ETML-ES-SLO/PRJ_2002_CapteurMeteoWifi/2002_C/doc/PV/ProcèsVerbal_05.09.2024.docx

TD 2002 Capteur Wi-fi

Procès-verbal - du 05.09.2024

Présents

- M. Marques (JMS)
- M. Bovey (PBY)

État des lieux

- Software :
  1. Fonctionnement du capteur pour ensuite réaliser l’algorithme pour une prévision météo : 100%
  2. Communication avec la RTC, configuration du mode réveil : 90%
  3. Communication USB-UART : 90%
  4. Configuration de l’ESP32, PC-ESP32 : 100%
  5. Communication UART de l’ESP32, uC-ESP32 : 90%
  6. Sauvegarde data dans la flash : 90%
  7. Algorithme et analyse sur les data : 70%
  8. Algorithme sur la gestion de la LED RGB : 30%
  9. Algorithme sur la gestion d’alimentation : 30%

Problèmes rencontrés

- Sauvegarde dans la flash bloquer.
- Pas de communication avec la RTC.

Solutions proposées

- Faire les test et mesure pour la RTC avec Kit de PIC32 de l’écoel

Décisions prises

- Arrêter la partie firmware et se concentrer sur le rapport

Suite du projet / objectifs

Finir le rapport

Prochaine réunion :

Destinataires de ce PV

- Aurélie Cuagnier, Secrétaire de l’ETML-ES
- Philippe Bovey, Maître de diplôme

Lausanne le 05.09.2024

Joao Marques Chaves

Ecole supérieure, école des métiers Lausanne V.1-0 Rue de Sébeillon 12 DR / 13.08.2020 du 09.09.2024 CH-1004 Lausanne www.etml-es.ch H:\2002_C\doc\PV\ProcèsVerbal_05.09.2024.docx | 1 / 1 |

ETML – Ecole supérieure
