ETML-ES-SLO/PRJ_2002_CapteurMeteoWifi/2002_C/doc/PV/ProcèsVerbal_14.08.2024.docx

TD 2002 Capteur Wi-fi

Procès-verbal - du 14.08.2024

Présents

- M. Marques (JMS)
- M. Bovey (PBY)

État des lieux

- Schématique :
  - Alimentation.
    - USB-C
      - Convertisseur USB-UART
    - Pile/Accu
      - Contrôleur de charge.
        - Commande MOSFET.
  - RTC
  - ESP32
  - Capteur (humidité, température, pression, qualité d’air).
  - Led RGB, Led de vie
- Revue de Schéma avec M.Bovey le lundi 12.08.2024.
- Planning.
  - Il y a eu une déviation par rapport à ce qui était prévu (1 à 2 jours de retard). Une partie de ce retard est due au temps passé lors de la première semaine à effectuer des tests sur le prototype actuel.

Problèmes rencontrés

- Alimentation :
  - Contrôleur de charge :
    - Commande MOSFET, il s’agit d’un MOSFET qui est commandé par l’une des sorties des microcontrôleurs. Son rôle est de débrancher les piles/accumulateurs en cas de problème détecté lors de la charge ou si des piles non rechargeables sont détectées.
      - Difficulté à estimer les caractéristiques du MOSFET, telles que VGS (th).

Solutions proposées

- Alimentation :
  - Contrôleur de charge :
    - Tension VGS (th) doit commuter à partir de 3v, tension a la source 6V et à la gâte 3.3, cela fait une différence de 2.7V. Rechercher un MOSFET à canal P avec un VGS (th) de minium 3V.

Décisions prises

- Alimentation :
  - Contrôleur de charge :
    - Recherche d’un MOSFET a canal P avec un VGS (th) de minimum 3V garanti pour un courant max 1-2A.

Suite du projet / objectifs

- Commande de composant
- Réalisation du PCB
- Connaitre les contraintes pour le boitier, pour une idée globale du design.
- Rapport
  - Finir la rédaction de la prés-étude.
  - Finir la rédaction du design.

Prochaine réunion :

16.08.2024, 16h30, salle R110 ETML-ES Revu du PCB

21.08.2024, 10h00, salle R110 ETML-ES Séance classique

Destinataires de ce PV

- Grégoire Rossier, Doyen de l’ETML-ES
- Philippe Bovey, Maître de diplôme

Lausanne le 14.08.2024

Joao Marques Chaves

Ecole supérieure, école des métiers Lausanne V.1-0 Rue de Sébeillon 12 DR / 13.08.2020 du 16.08.2024 CH-1004 Lausanne www.etml-es.ch H:\2002_C\doc\PV\ProcèsVerbal_14.08.2024.docx | 1 / 1 |

ETML – Ecole supérieure
