ETML-ES-SLO/PRJ_2002_CapteurMeteoWifi/2002_C/doc/2002_CapteurMeteoWifi-PLANNING.pdf

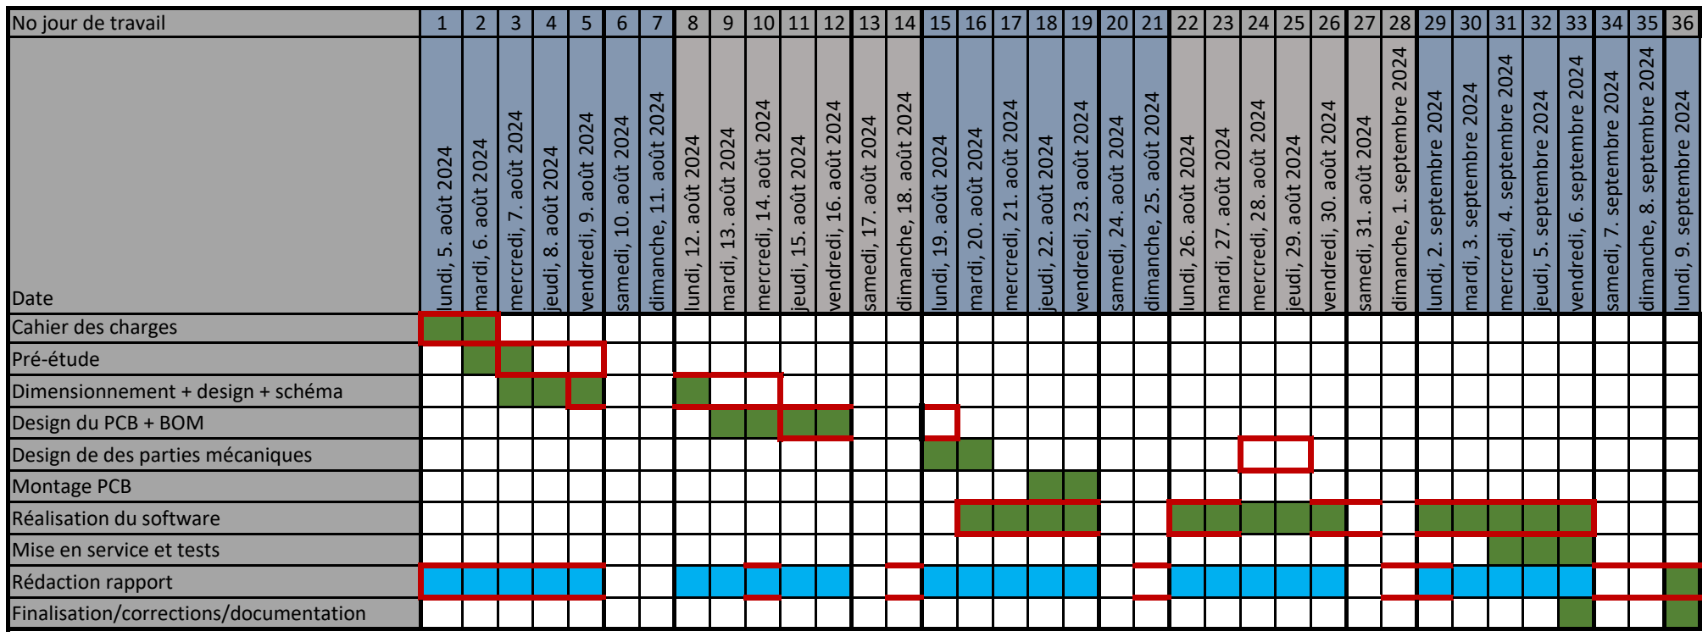
[picture p1: figure]
No jour de travail; Date; lundi, 5. août 2024; mardi, 6. août 2024; mercredi, 7. août 2024; jeudi, 8. août 2024; vendredi, 9. août 2024; samedi, 10. août 2024; dimanche, 11. août 2024; lundi, 12. août 2024; mardi, 13. août 2024; mercredi, 14. août 2024; jeudi, 15. août 2024; vendredi, 16. août 2024; samedi, 17. août 2024; dimanche, 18. août 2024; lundi, 19. août 2024; mardi, 20. août 2024; mercredi, 21. août 2024; jeudi, 22. août 2024; vendredi, 23. août 2024; samedi, 24. août 2024; dimanche, 25. août 2024; lundi, 26. août 2024; mardi, 27. août 2024; mercredi, 28. août 2024; jeudi, 29. août 2024; vendredi, 30. août 2024; samedi, 31. août 2024; dimanche, 1. septembre 2024; lundi, 2. septembre 2024; mardi, 3. septembre 2024; mercredi, 4. septembre 2024; jeudi, 5. septembre 2024; vendredi, 6. septembre 2024; samedi, 7. septembre 2024; dimanche, 8. septembre 2024; lundi, 9. septembre 2024; Cahier des charges Pré-étude Dimensionnement + design + schéma Design du PCB + BOM Design de des parties mécaniques Montage PCB Réalisation du software Mise en service et tests Rédaction rapport Finalisation/corrections/documentation
