ETML-ES-SLO/PRJ_2002_CapteurMeteoWifi/2002_C/hard/2002_C/Project Outputs for 2002_CapteurMeteoWifi/DesignDocs/Bill of Materials.PDF

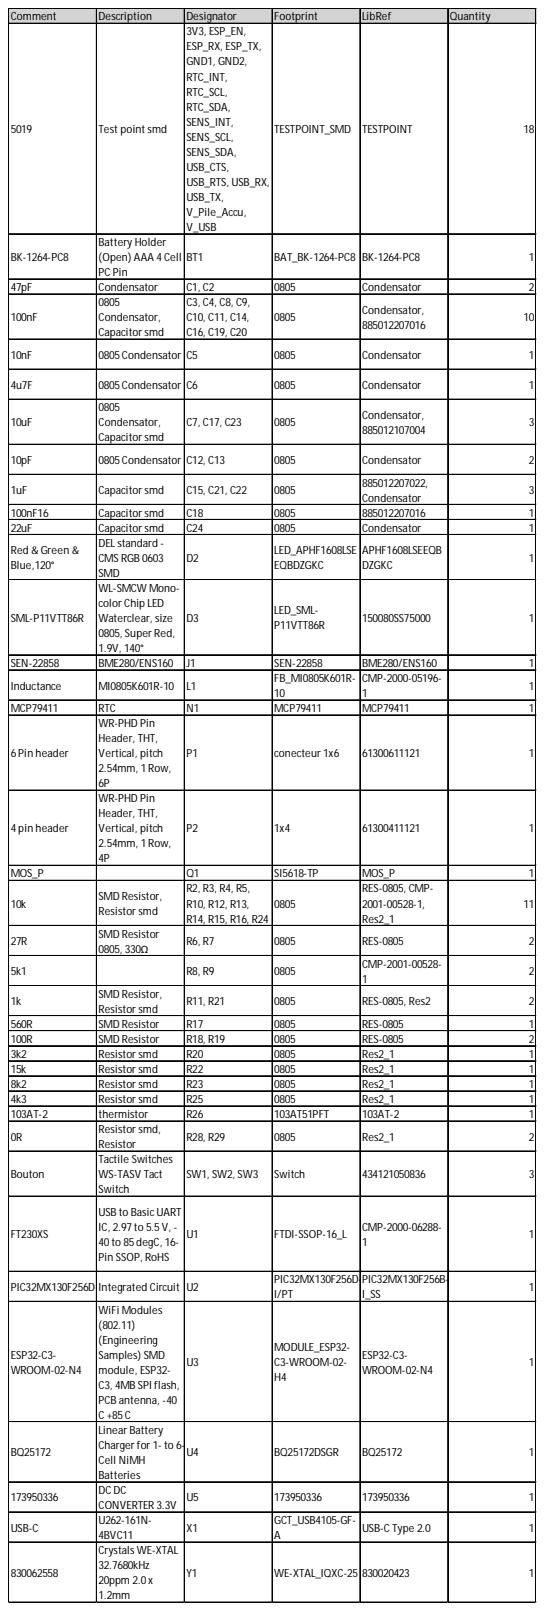
[picture p69: page 1]

Comment | Description | Designator | Footprint | LibRef | Quantity
5019 | Test point smd | 3V3, ESP_EN, ESP_RX, ESP_TX, GND1, GND2, RTC_INT, RTC_SCL, RTC_SDA, SENS_INT, SENS_SCL, SENS_SDA, USB_CTS, USB_RTS, USB_RX, USB_TX, V_Pile_Accu, V_USB | TESTPOINT_SMD | TESTPOINT | 18

BK-1264-PC8 | Battery Holder (Open) AAA 4 Cell PC Pin | BT1 | BAT_BK-1264-PC8 | BK-1264-PC8 | 1

47pF | Condensator | C1, C2 | 0805 | Condensator | 2
100nF | 0805 Condensator, Capacitor smd | C3, C4, C8, C9, C10, C11, C14, C16, C19, C20 | 0805 | Condensator, 885012207016 | 10

10nF | 0805 Condensator | C5 | 0805 | Condensator | 1

4u7F | 0805 Condensator | C6 | 0805 | Condensator | 1

10uF | 0805 Condensator, Capacitor smd | C7, C17, C23 | 0805 | Condensator, 885012107004 | 3

10pF | 0805 Condensator | C12, C13 | 0805 | Condensator | 2

1uF | Capacitor smd | C15, C21, C22 | 0805 | 885012207022, Condensator | 3

100nF16 | Capacitor smd | C18 | 0805 | 885012207016 | 1
22uF | Capacitor smd | C24 | 0805 | Condensator | 1
Red & Green & Blue,120° | DEL standard -CMS RGB 0603 SMD | D2 | LED_APHF1608LSE EQBDZGKC | APHF1608LSEEQB DZGKC | 1

SML-P11VTT86R | WL-SMCW Mono-color Chip LED Waterclear, size 0805, Super Red, 1.9V, 140° | D3 | LED_SML-P11VTT86R | 150080SS75000 | 1

SEN-22858 | BME280/ENS160 | J1 | SEN-22858 | BME280/ENS160 | 1
Inductance | MI0805K601R-10 | L1 | FB_MI0805K601R-10 | CMP-2000-05196-1 | 1

MCP79411 | RTC | N1 | MCP79411 | MCP79411 | 1
6 Pin header | WR-PHD Pin Header, THT, Vertical, pitch 2.54mm, 1 Row, 6P | P1 | conecteur 1x6 | 61300611121 | 1

4 pin header | WR-PHD Pin Header, THT, Vertical, pitch 2.54mm, 1 Row, 4P | P2 | 1x4 | 61300411121 | 1

MOS_P | | Q1 | SI5618-TP | MOS_P | 1
10k | SMD Resistor, Resistor smd | R2, R3, R4, R5, R10, R12, R13, R14, R15, R16, R24 | 0805 | RES-0805, CMP-2001-00528-1, Res2_1 | 11

27R | SMD Resistor 0805, 330Ω | R6, R7 | 0805 | RES-0805 | 2

5k1 | | R8, R9 | 0805 | CMP-2001-00528-1 | 2

1k | SMD Resistor, Resistor smd | R11, R21 | 0805 | RES-0805, Res2 | 2

560R | SMD Resistor | R17 | 0805 | RES-0805 | 1
100R | SMD Resistor | R18, R19 | 0805 | RES-0805 | 2
3k2 | Resistor smd | R20 | 0805 | Res2_1 | 1
15k | Resistor smd | R22 | 0805 | Res2_1 | 1
8k2 | Resistor smd | R23 | 0805 | Res2_1 | 1
4k3 | Resistor smd | R25 | 0805 | Res2_1 | 1
103AT-2 | thermistor | R26 | 103AT51PFT | 103AT-2 | 1
0R | Resistor smd, Resistor | R28, R29 | 0805 | Res2_1 | 2

Bouton | Tactile Switches WS-TASV Tact Switch | SW1, SW2, SW3 | Switch | 434121050836 | 3

FT230XS | USB to Basic UART IC, 2.97 to 5.5 V, -40 to 85 degC, 16-Pin SSOP, RoHS | U1 | FTDI-SSOP-16_L | CMP-2000-06288-1 | 1

PIC32MX130F256D Integrated Circuit | | U2 | PIC32MX130F256D-I/PT | PIC32MX130F256B-I_SS | 1

ESP32-C3-WROOM-02-N4 | WiFi Modules (802.11) (Engineering Samples) SMD module, ESP32-C3, 4MB SPI flash, PCB antenna, -40 C +85 C | U3 | MODULE_ESP32-C3-WROOM-02-H4 | ESP32-C3-WROOM-02-N4 | 1

BQ25172 | Linear Battery Charger for 1- to 6-Cell NiMH Batteries | U4 | BQ25172DSGR | BQ25172 | 1

173950336 | DC DC CONVERTER 3.3V | U5 | 173950336 | 173950336 | 1

USB-C | U262-161N-4BVC11 | X1 | GCT_USB4105-GF-A | USB-C Type 2.0 | 1

830062558 | Crystals WE-XTAL 32.7680kHz 20ppm 2.0 x 1.2mm | Y1 | WE-XTAL_IQXC-25 830020423 | | 1
