ETML-ES-SLO/PRJ_2002_CapteurMeteoWifi/2002_C/doc/2002_CapteurMeteoWifi-JOURNAL.pdf

Jour | Date | Nbr période | Tâches effectuées
Lundi | 05.08.2024 | 7 | Réception et analyse du cahier des charges, préparation des documents de base, recherche d'informations sur le prototype.
Mardi | 06.08.2024 | 9 | mise en service du routeur, test du prototype, test et recherche sur le fonctionnement de domoticz et des requete http. Commencement du rapport.
Mercredi | 07.08.2024 | 9 | debut de la pre-etude, recherche sur les pile akaline et nimh, ic de gestion de baterie, recherche info sur la consomation global du sytheme.
Jeudi | 08.08.2024 | 10 | control si le micro du prototype reste adapter pour la nouvelle version, seance avec M.Bovey, réalisation du PV.
Vendredi | 09.08.2024 | 9 | correction prés etude(schéma bloc),recherche des dernier composant et debut de la schématique
Samedi | 10.08.2024
Dimanche | 11.08.2024
Lundi | 12.08.2024 | 9 | realisation de la schématique,revu de schéma avec M.bovey
Mardi | 13.08.2024 | 10 | modification du schéma+boom
Mercredi | 14.08.2024 | 8 | finalisation du schéma et de la boom, commande des coposant,seance avec M.Bovey,Réalisation du PV.
Jeudi | 15.08.2024 | 9 | control si tout les footprint present et mise en place des composant sur le pcb
Vendredi | 16.08.2024 | 9 | Routage du PCB,Revu du PCB avec M.Bovey
Samedi | 17.08.2024
Dimanche | 18.08.2024 | 4 | rapport(prés-étude,design)
Lundi | 19.08.2024 | 9 | Finalisation du PCB et commande du PCB
Mardi | 20.08.2024 | 6 | absence le matin pour maladie, debut de recherche pour soft.
Mercredi | 21.08.2024 | 9 | Recherche soft sur l'esp32 et le capteur, seance avec M.Bovey, réalisation du PV.
Jeudi | 22.08.2024 | 9 | recherche et test sur le soft du BM280
Vendredi | 23.08.2024 | 9 | lecture temperature,humidité et presion reusite, recherche et test sur le capteur ens160, Lecture qualité d'aire reussite
Samedi | 24.08.2024
Dimanche | 25.08.2024
Lundi | 26.08.2024 | 9 | rechechre et test RTC
Mardi | 27.08.2024 | 9 | tester d'endormir le micro et de le reveiler avec l'alarme de la rtc, recherche sur mqtt, visite expert
Mercredi | 28.08.2024 | 10 | montage du PCB
Jeudi | 29.08.2024 | 11 | finalisation du montage du PCB(Rtc modif),configuration externe de l'esp32
Vendredi | 30.08.2024 | 10 | comunication USB-UART etablie,Lecture des capteur BME280 et ENS160
Samedi | 31.08.2024 | 3 | realisation d'un serveur mqtt avec mosquitto sur pc-portable personnel et recherche sur la manière a comuniquer(publish,subscribe et topic)
Dimanche | 01.09.2024 | 5 | Rapport finalisation des premiere partie (explication projet, pré-étude, design electique)+explication brouillon de la configuration de l'esp32
Lundi | 02.09.2024 | 12 | connexion au serveur mqtt et envoie de donnée sur des topic et test reseption avec une apli qui s'abonnent au topic utillisé
Mardi | 03.09.2024 | 13 | mise en forme code present et realisation de fonction pour harmoniser le code,rapport (diagramme des fonction)
Mercredi | 04.09.2024 | 15 | connexion serveur TCP et envoie de donné,sauvegarde flash,rapport (explication brouillon des siagramme)
Jeudi | 05.09.2024 | 10 | Sauvegarde Flash,menu, test ADC lecture sur les cellule, rapport
Vendredi | 06.09.2024 | 14 | test sur la RTC avec Kit pic32 de l'etml, mesure I2c,BME280,ENS160,MCp74911, mesure Uart du FT230x et de l'ESP32, mesure alimentation
Samedi | 07.09.2024 | 9 | Rapport
Dimanche | 08.09.2024 | 10 | Rapport
Lundi | 09.09.2024 | 3 | Annexe fiinalisation plus rapport
Total | 278
