ETML-ES-SLO/PRJ_2002_CapteurMeteoWifi/2002_C/doc/2002_CapteurMeteoWifi-JOURNAL.xlsx

Jour | Date | Nbr période | Tâches effectuées
Lundi | 2024-08-05 | 7 | Réception et analyse du cahier des charges, préparation des documents de base, recherche d'informations sur le prototype.
Mardi | 2024-08-06 | 9 | mise en service du routeur, test du prototype, test et recherche sur le fonctionnement de domoticz et des requete http. Commencement du rapport.
Mercredi | 2024-08-07 | 9 | debut de la pre-etude, recherche sur les pile akaline et nimh, ic de gestion de baterie, recherche info sur la consomation global du sytheme.
Jeudi | 2024-08-08 | 10 | control si le micro du prototype reste adapter pour la nouvelle version, seance avec M.Bovey, réalisation du PV.
Vendredi | 2024-08-09 | 9 | correction prés etude(schéma bloc),recherche des dernier composant et debut de la schématique
Samedi | 2024-08-10
Dimanche | 2024-08-11
Lundi | 2024-08-12 | 9 | realisation de la schématique,revu de schéma avec M.bovey
Mardi | 2024-08-13 | 10 | modification du schéma+boom
Mercredi | 2024-08-14 | 8 | finalisation du schéma et de la boom, commande des coposant,seance avec M.Bovey,Réalisation du PV.
Jeudi | 2024-08-15 | 9 | control si tout les footprint present et mise en place des composant sur le pcb
Vendredi | 2024-08-16 | 9 | Routage du PCB,Revu du PCB avec M.Bovey
Samedi | 2024-08-17
Dimanche | 2024-08-18 | 4 | rapport(prés-étude,design)
Lundi | 2024-08-19 | 9 | Finalisation du PCB et commande du PCB
Mardi | 2024-08-20 | 6 | absence le matin pour maladie, debut de recherche pour soft.
Mercredi | 2024-08-21 | 9 | Recherche soft sur l'esp32 et le capteur, seance avec M.Bovey, réalisation du PV.
Jeudi | 2024-08-22 | 9 | recherche et test sur le soft du BM280
Vendredi | 2024-08-23 | 9 | lecture temperature,humidité et presion reusite, recherche et test sur le capteur ens160, Lecture qualité d'aire reussite
Samedi | 2024-08-24
Dimanche | 2024-08-25
Lundi | 2024-08-26 | 9 | rechechre et test RTC
Mardi | 2024-08-27 | 9 | tester d'endormir le micro et de le reveiler avec l'alarme de la rtc, recherche sur mqtt, visite expert
Mercredi | 2024-08-28 | 10 | montage du PCB
Jeudi | 2024-08-29 | 11 | finalisation du montage du PCB(Rtc modif),configuration externe de l'esp32
Vendredi | 2024-08-30 | 10 | comunication USB-UART etablie,Lecture des capteur BME280 et ENS160
Samedi | 2024-08-31 | 3 | realisation d'un serveur mqtt avec mosquitto sur pc-portable personnel et recherche sur la manière a comuniquer(publish,subscribe et topic)
Dimanche | 2024-09-01 | 5 | Rapport finalisation des premiere partie (explication projet, pré-étude, design electique)+explication brouillon de la configuration de l'esp32
Lundi | 2024-09-02 | 12 | connexion au serveur mqtt et envoie de donnée sur des topic et test reseption avec une apli qui s'abonnent au topic utillisé
Mardi | 2024-09-03 | 13 | mise en forme code present et realisation de fonction pour harmoniser le code,rapport (diagramme des fonction)
Mercredi | 2024-09-04 | 15 | connexion serveur TCP et envoie de donné,sauvegarde flash,rapport (explication brouillon des siagramme)
Jeudi | 2024-09-05 | 10 | Sauvegarde Flash,menu, test ADC lecture sur les cellule, rapport
Vendredi | 2024-09-06 | 14 | test sur la RTC avec Kit pic32 de l'etml, mesure I2c,BME280,ENS160,MCp74911, mesure Uart du FT230x et de l'ESP32, mesure alimentation
Samedi | 2024-09-07 | 9 | Rapport
Dimanche | 2024-09-08 | 10 | Rapport
Lundi | 2024-09-09 | 3 | Annexe fiinalisation plus rapport
 | Total | 278
