ETML-ES-SLO/PRJ_2002_CapteurMeteoWifi/2002_C/hard/2002_C/Project Outputs for 2002_CapteurMeteoWifi/DesignDocs/Schematic Prints.PDF

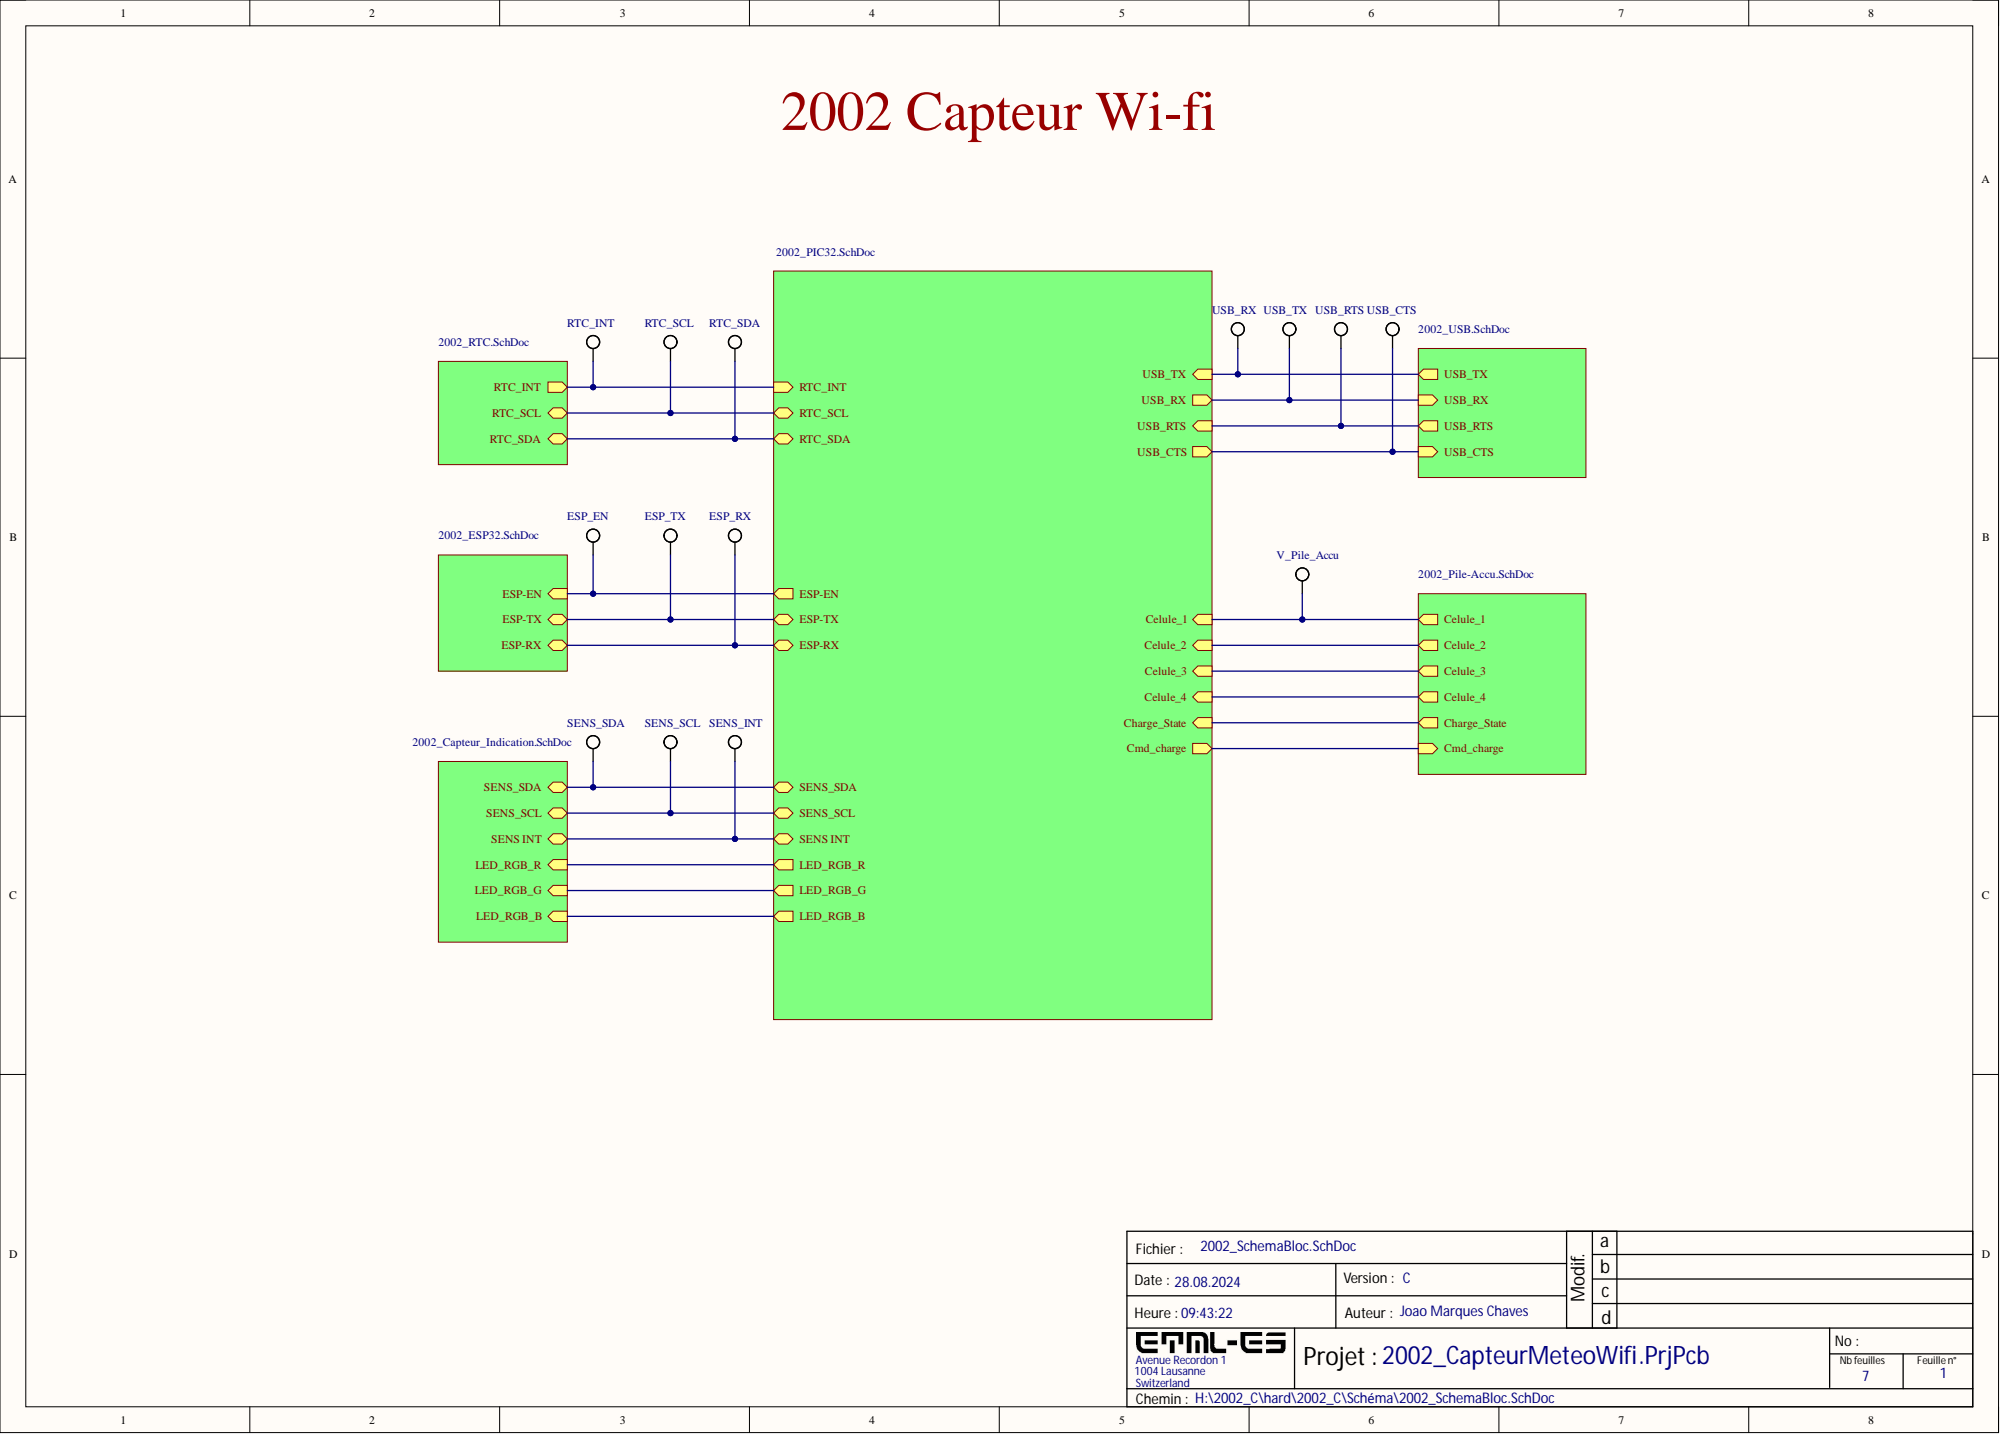
[picture p70: page 1]

2002_SchemaBloc.SchDoc Fichier : | | a

Date : 28.08.2024 | Version : C

Heure : 09:43:22 | Joao Marques Chaves Auteur :
Avenue Recordon 1 1004 Lausanne Switzerland | Projet : 2002_CapteurMeteoWifi.PrjPcb | No :

Nb feuilles 7 | Feuille n° 1

Chemin : H:\2002_C\hard\2002_C\Schéma\2002_SchemaBloc.SchDoc

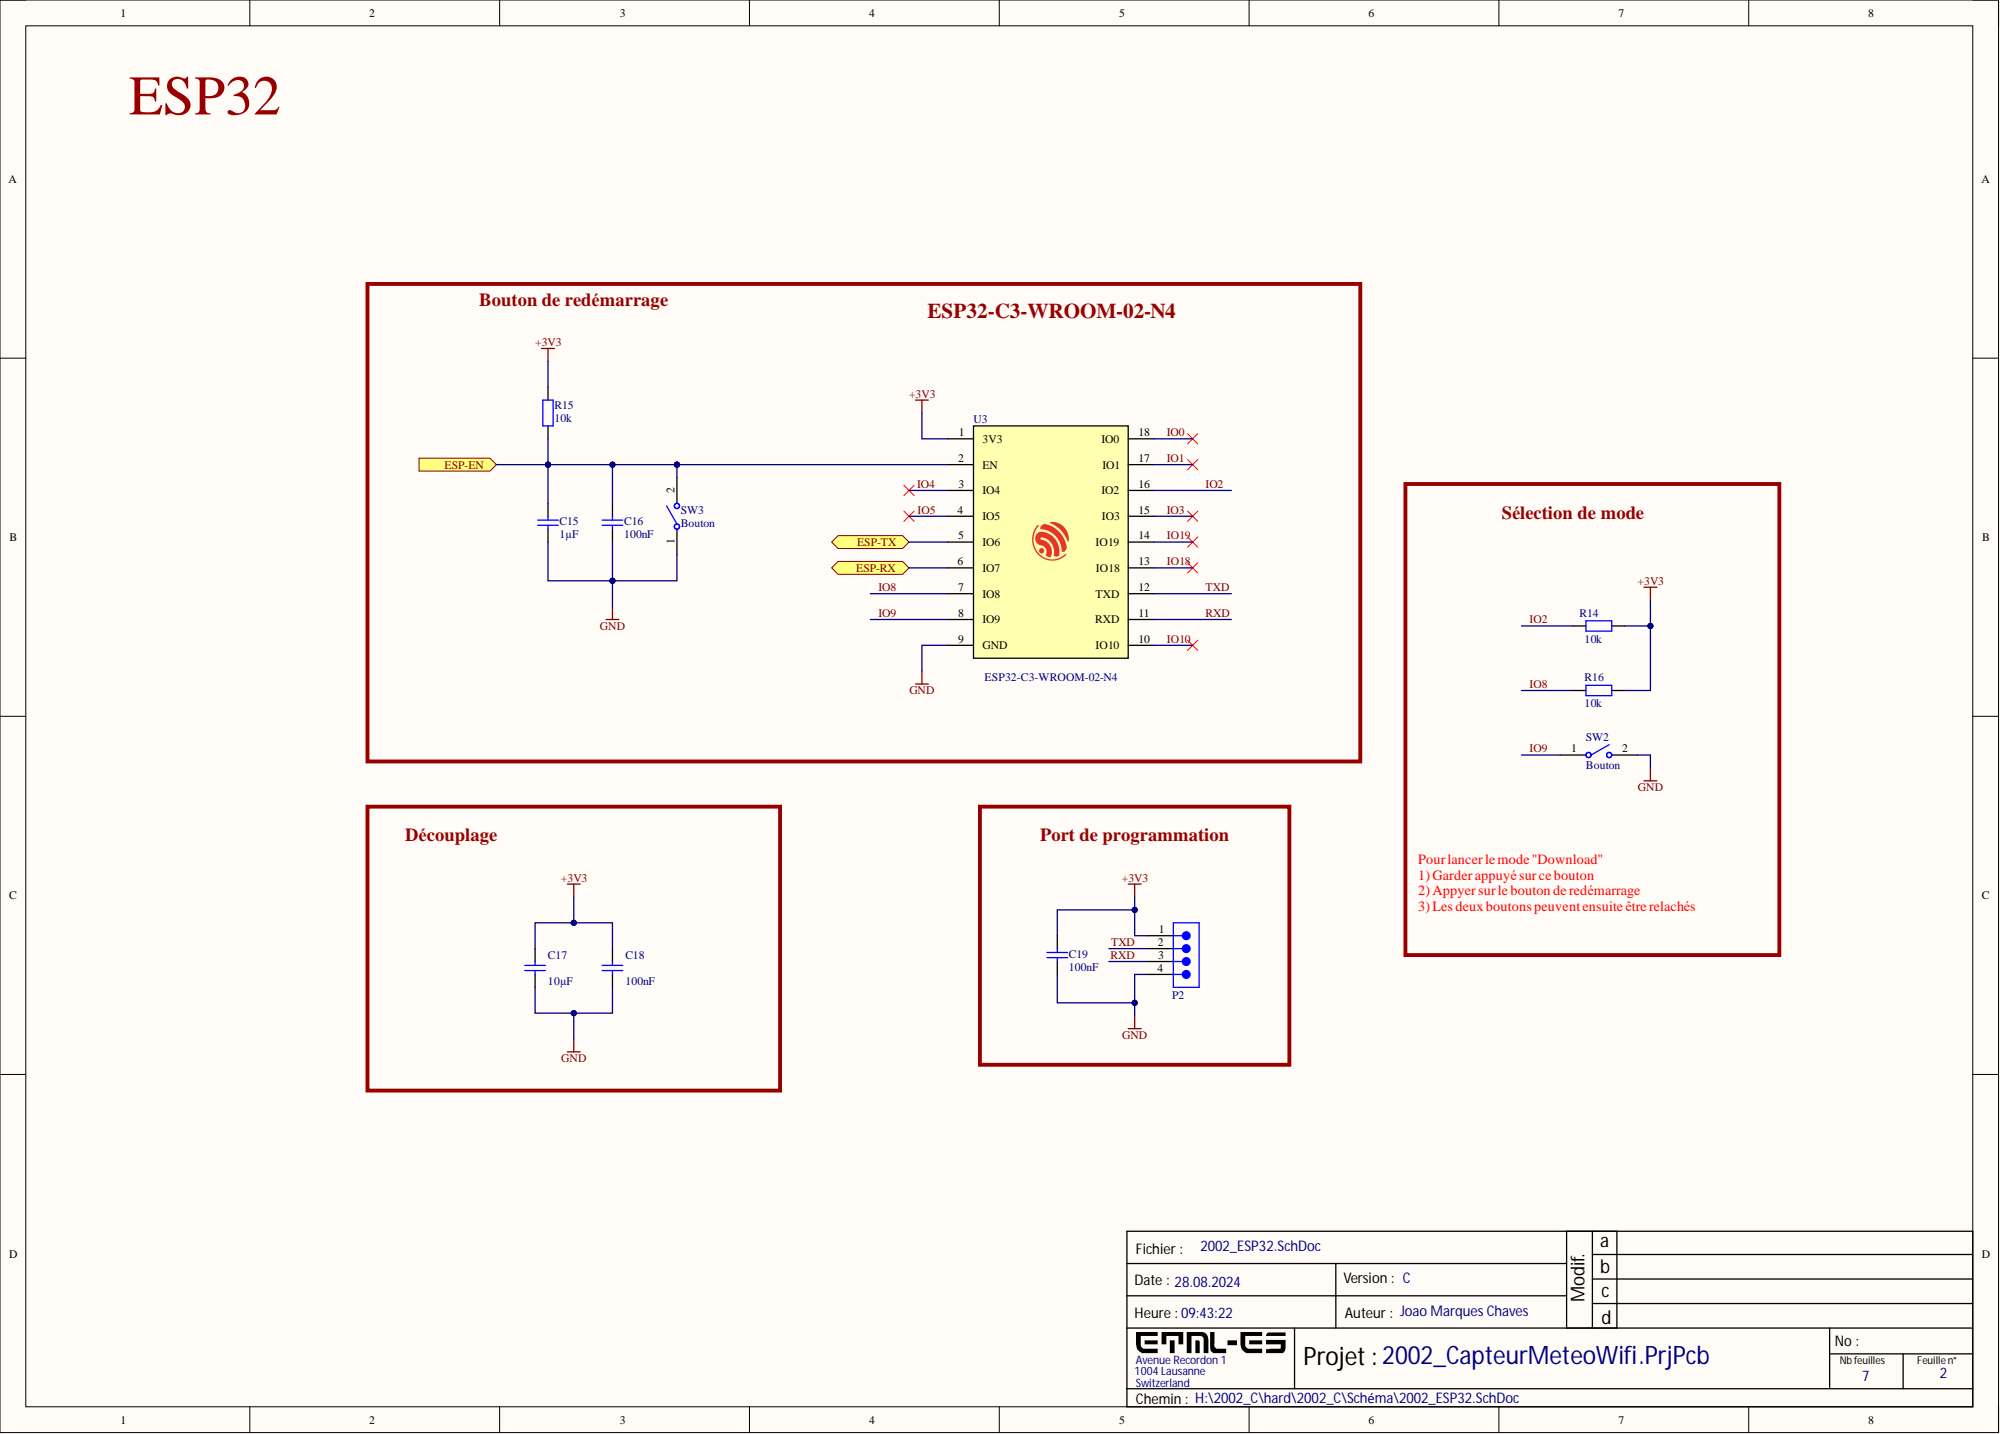
[picture p71: page 2]

2002_E S P32. S chDoc Fichier :

Date : 28.08.2024 | Version : C

Joao Marques Cha ves

Avenue R e cordon 1 4 Lausanne Switz rland | Projet : 2002_CapteurMeteoWifi.PrjPc b

Nb feuille s | F euille n °

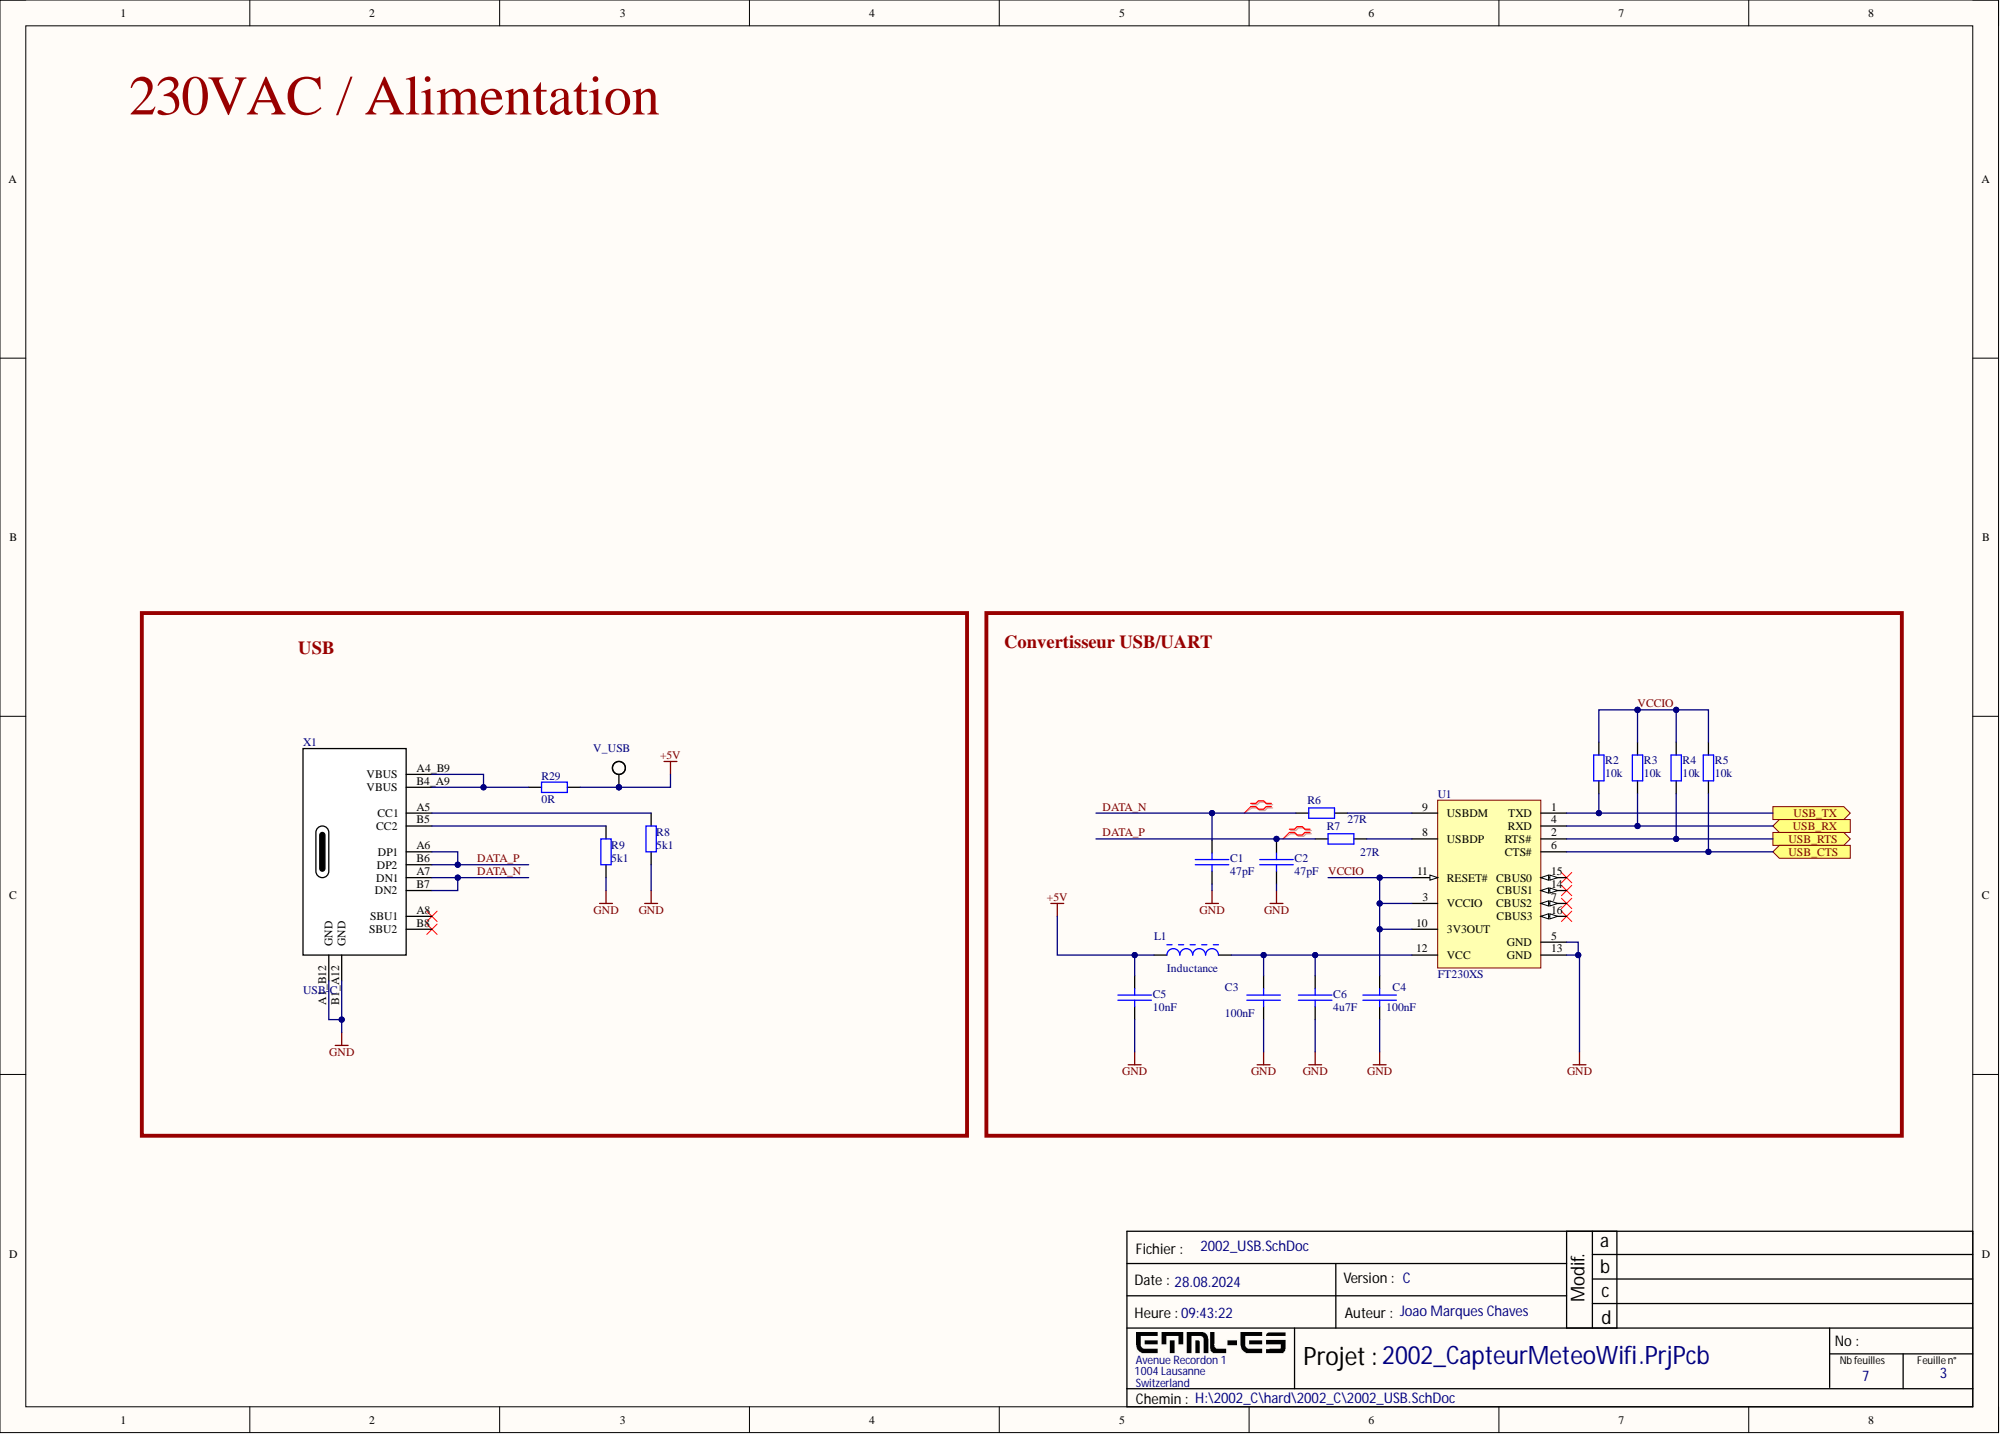
[picture p72: page 3]

2002_US B . S chDoc Fichier :

Date : 28.08.2024 | Version : C

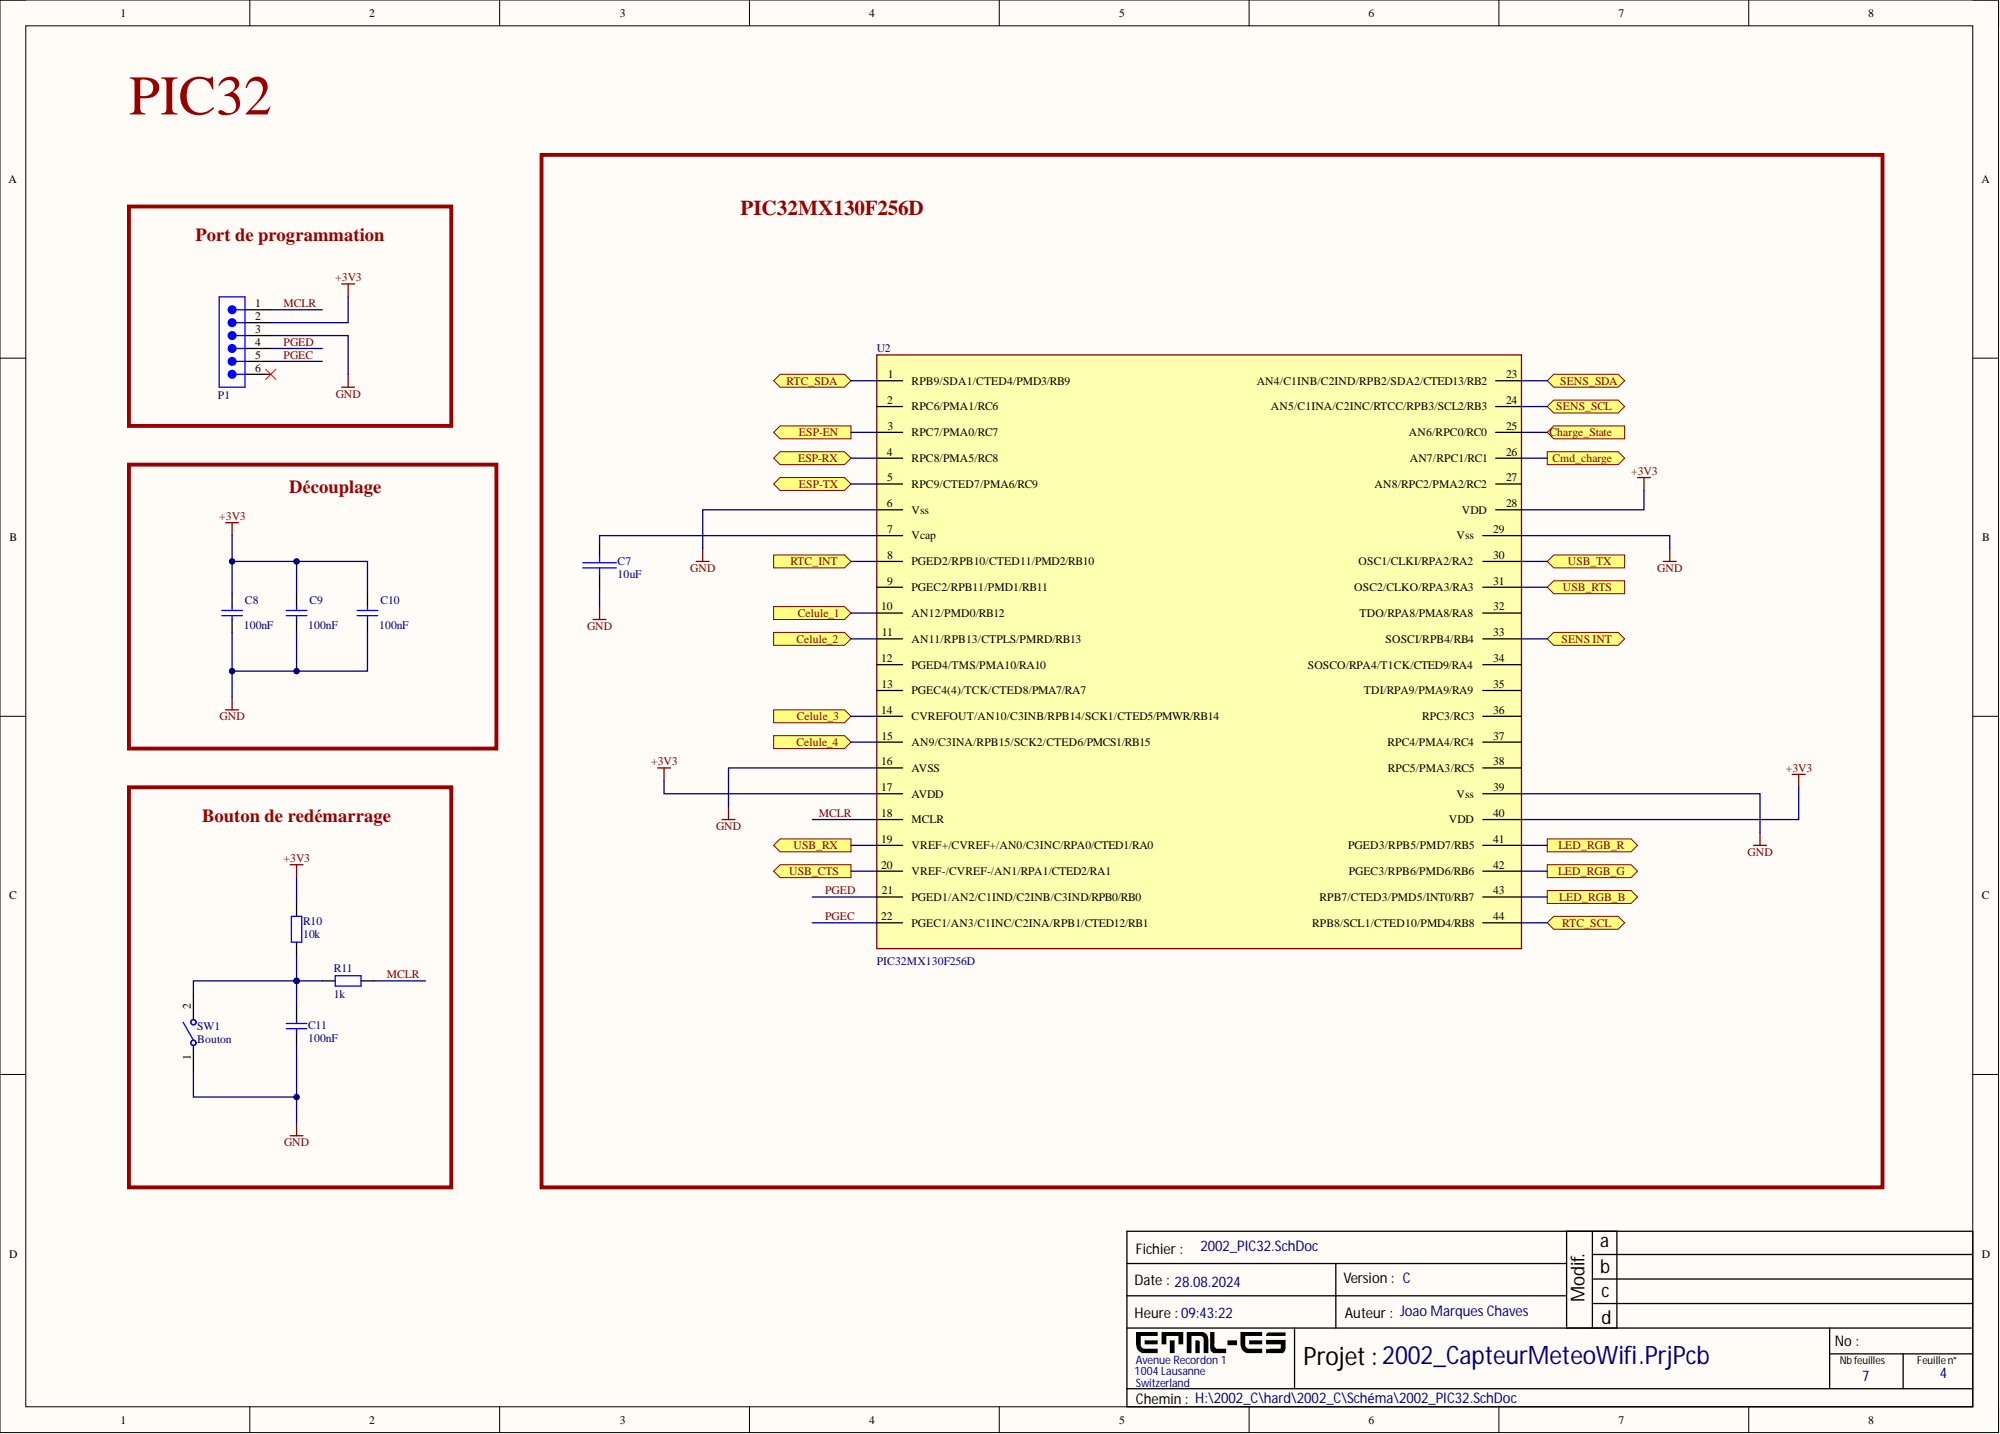
[picture p73: page 4]

2002_P IC32. S chDoc Fichier :

Date : 28.08.2024 | Version : C

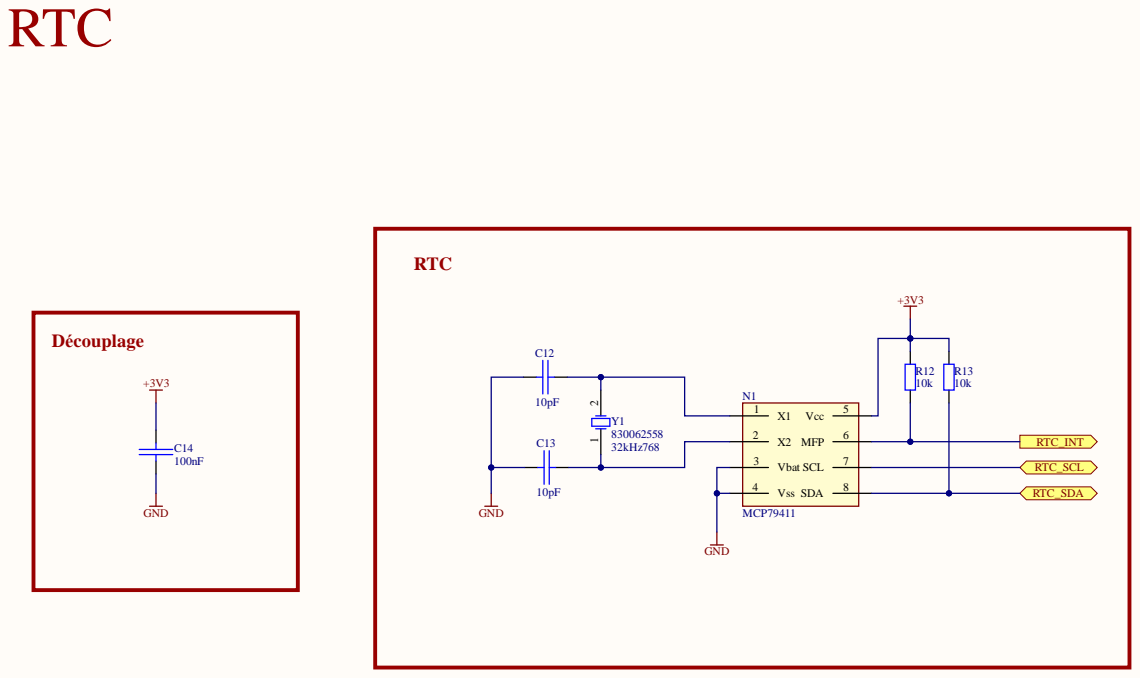
[picture p74: page 5]

2002_R TC. S chDoc Fichier :

Date : 28.08.2024 | Version : C

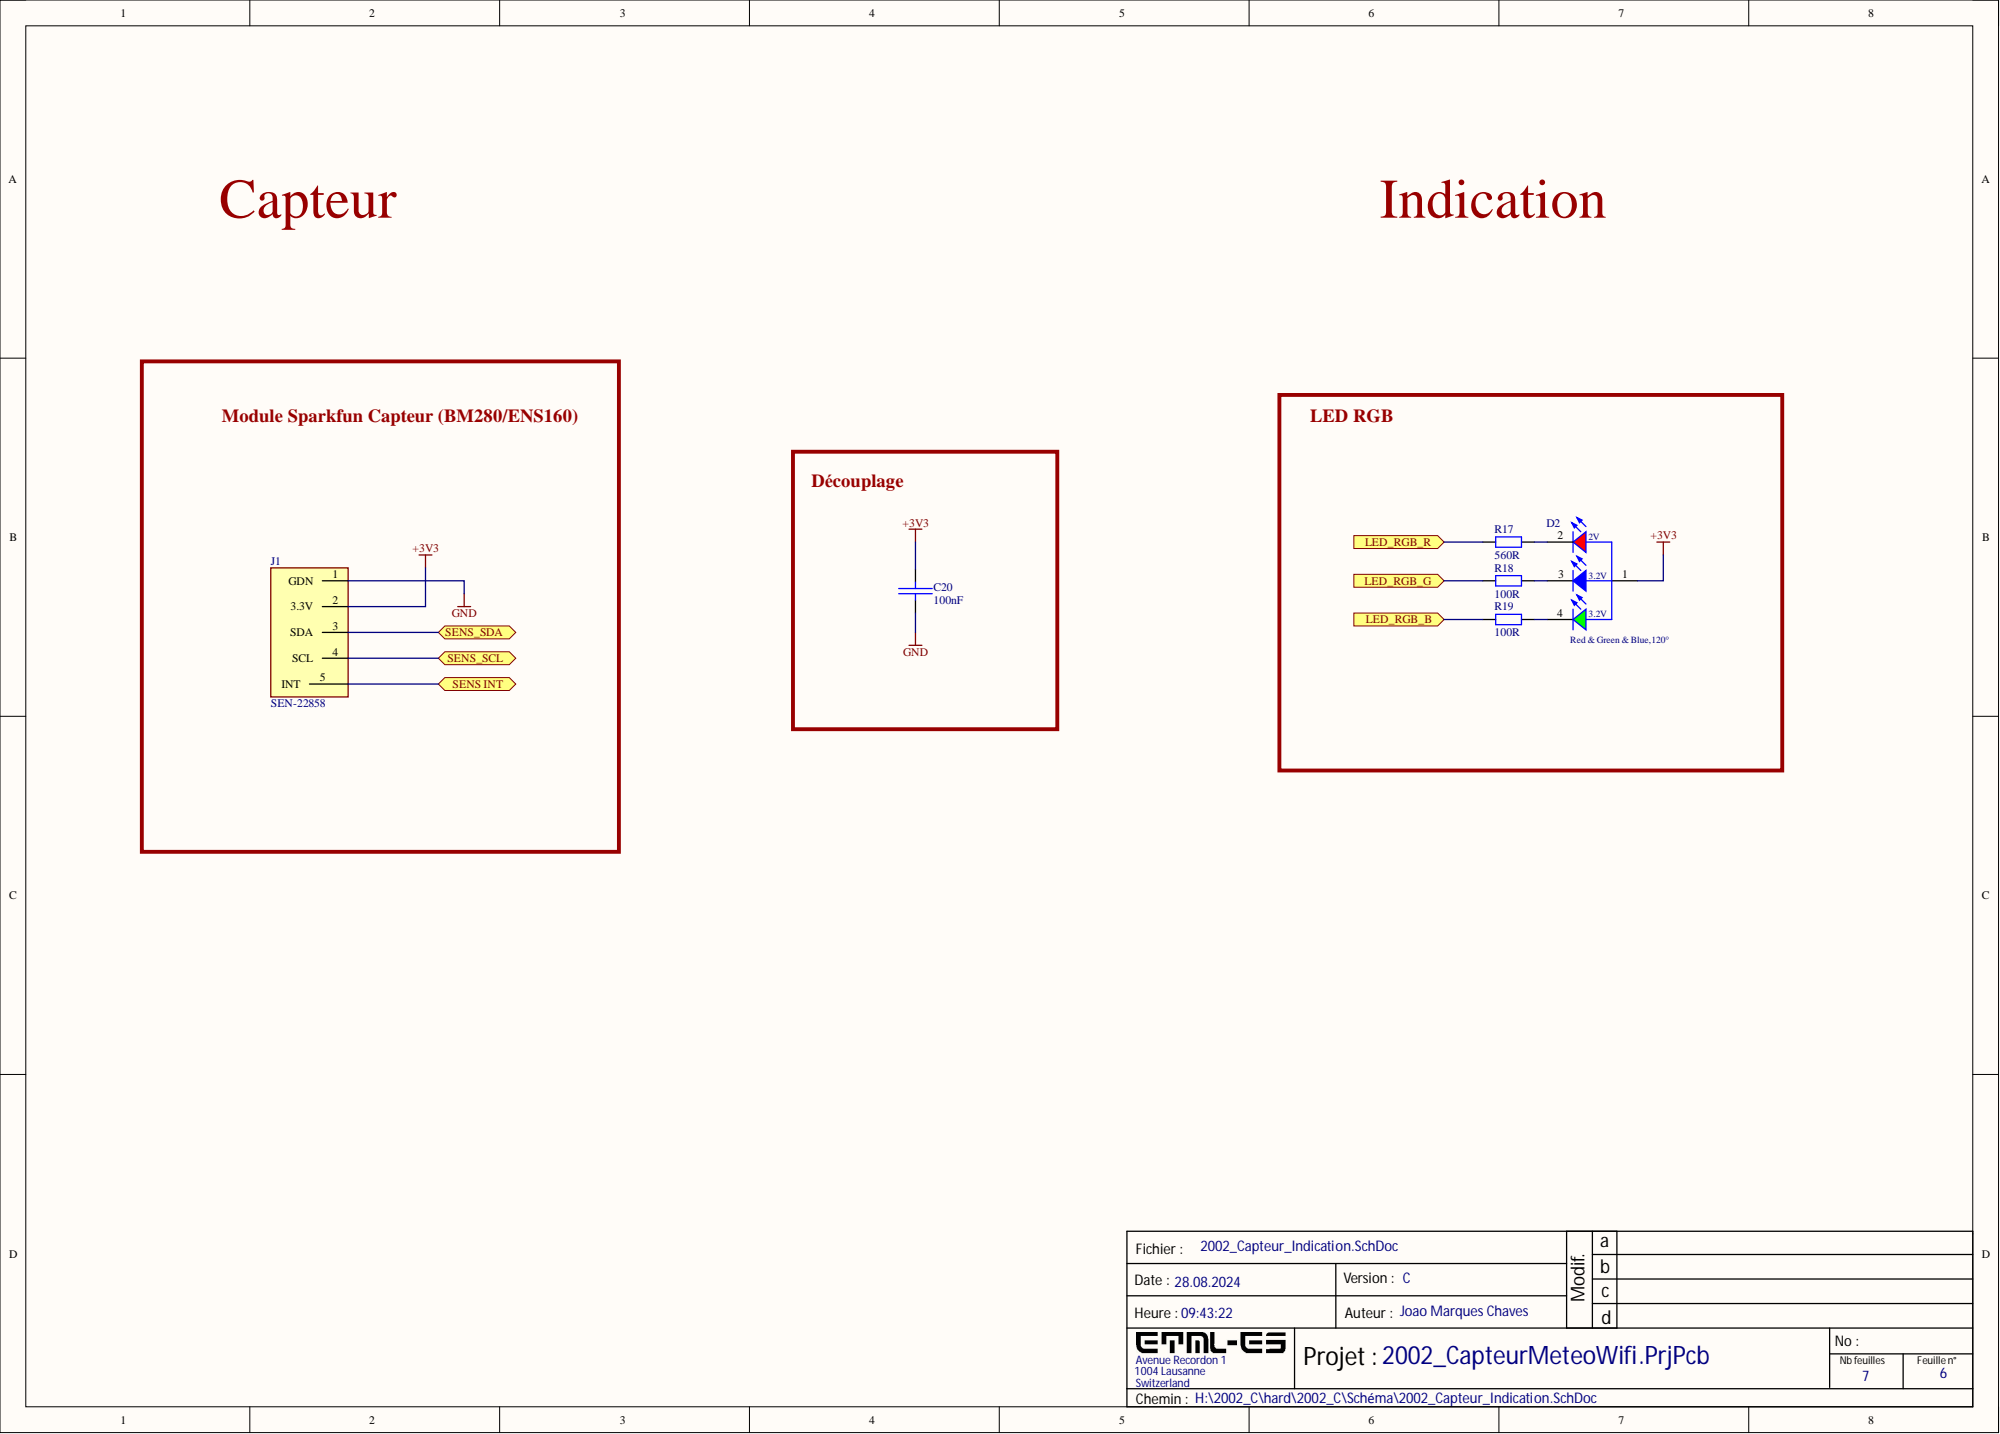
[picture p75: page 6]

2002_Capteur_Indicat ion. S chDoc Fichier :

Date : 28.08.2024 | Version : C

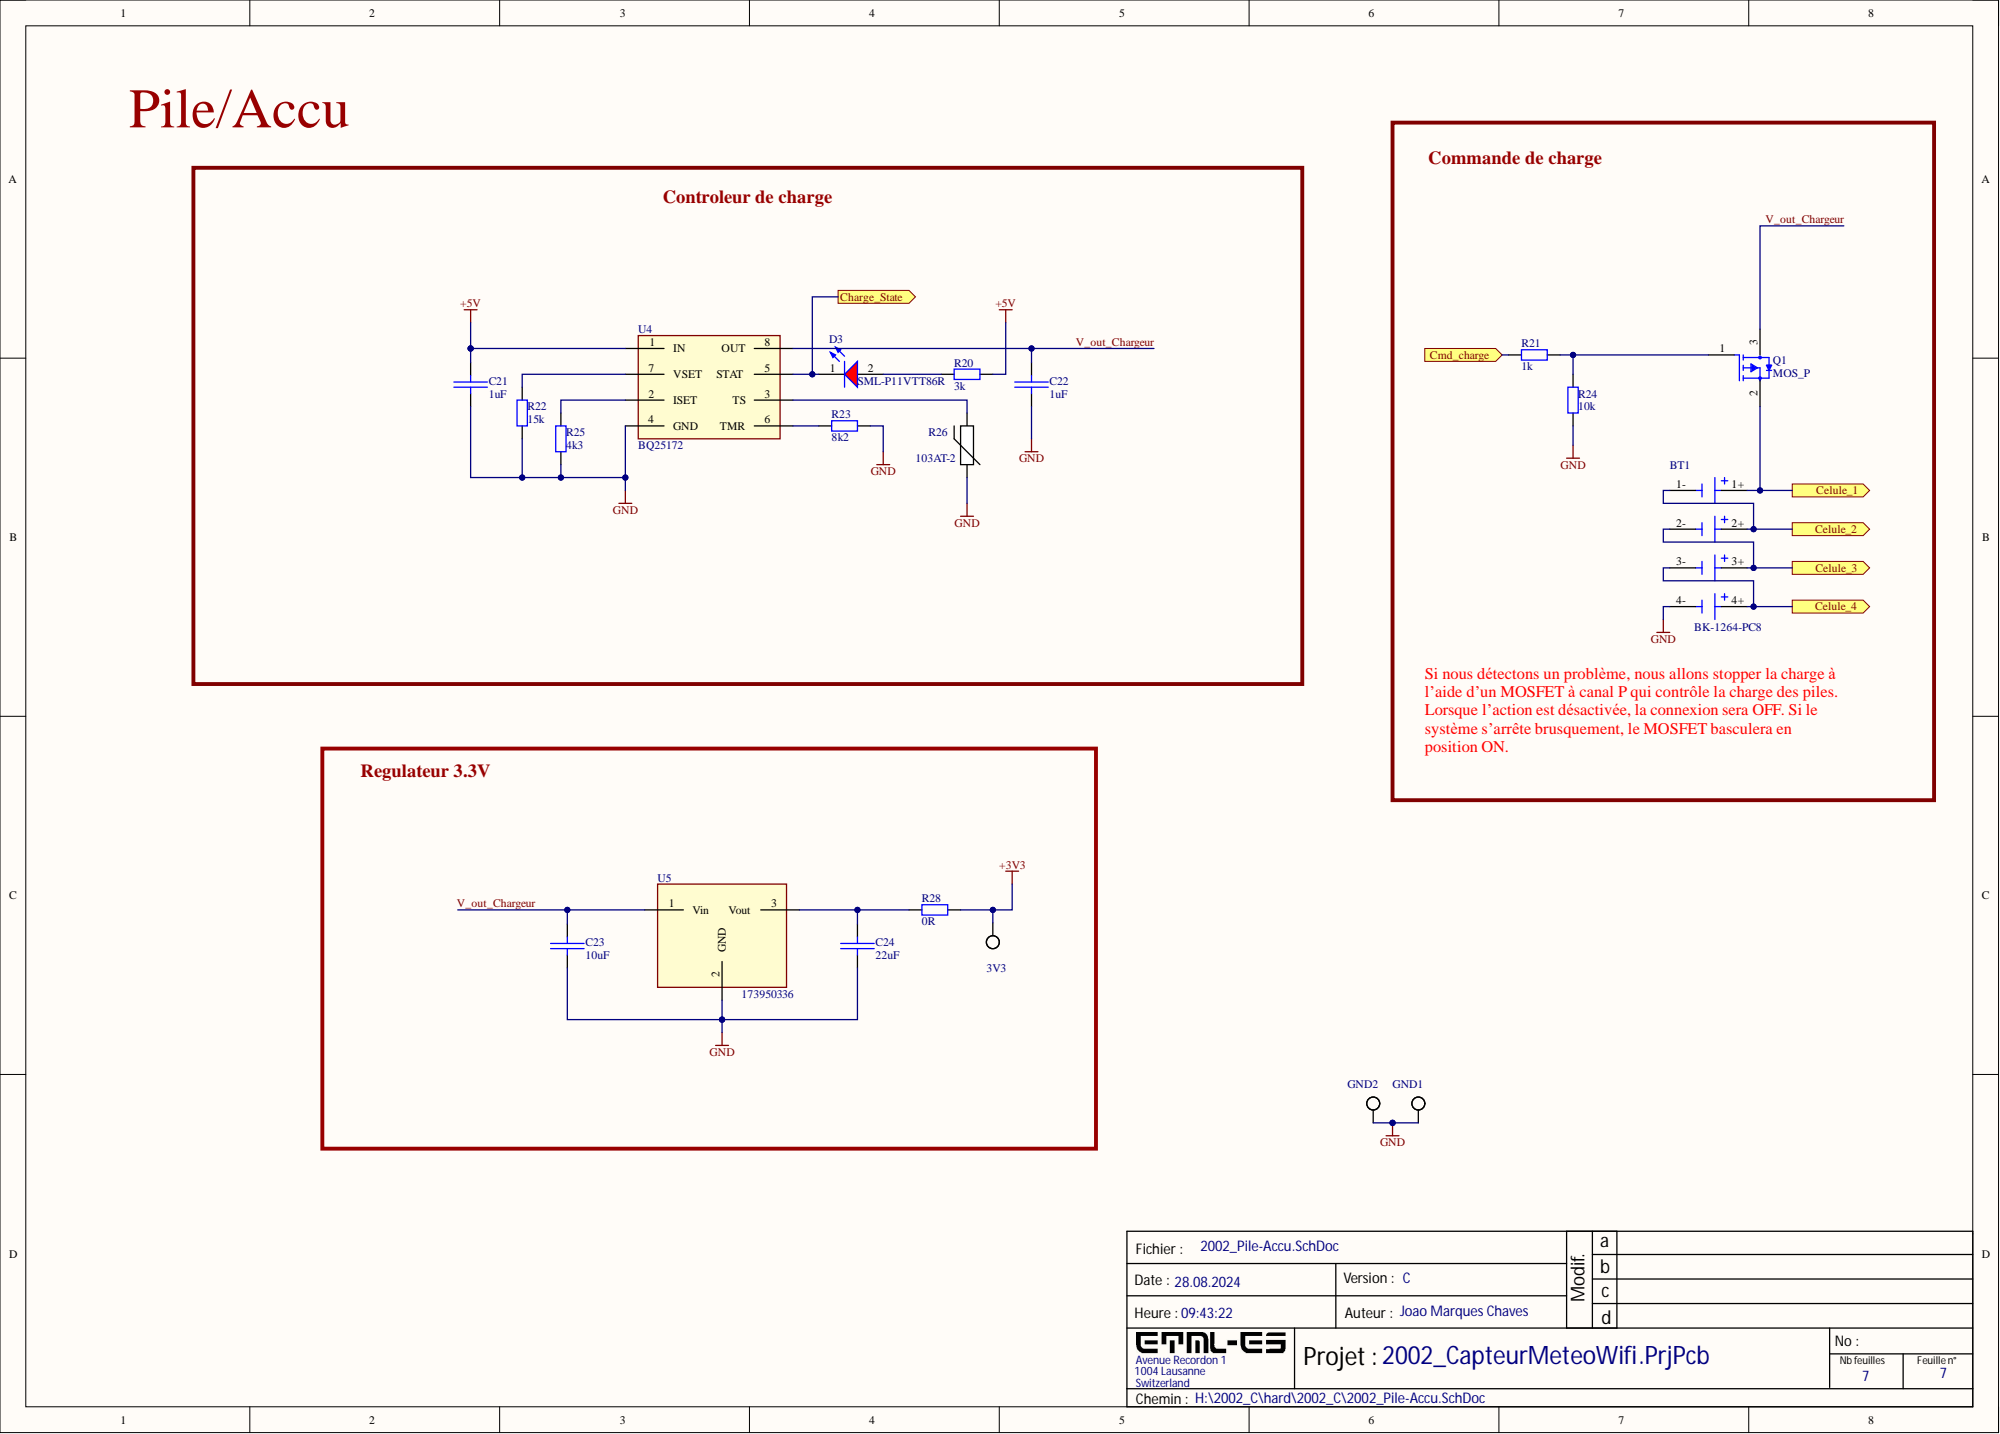
[picture p76: page 7]

Si nous détectons un problème, nous allons stopper la charge à
l’aide d’un MOSFET à canal P qui contrôle la charge des piles.
Lorsque l’action est désactivée, la connexion sera OFF. Si le
système s’arrête brusquement, le MOSFET basculera en
position ON.

2002_Pile-Accu.SchDoc Fichier : | | a

Date : 28.08.2024 | Version : C

Joao Marques Chaves

Avenue Recordon 1 1004 Lausanne Switzerland | Projet : 2002_CapteurMeteoWifi.PrjPcb

Nb feuilles 7 | Feuille n° 7

Chemin : H:\2002_C\hard\2002_C\2002_Pile-Accu.SchDoc
