ETML-ES-SLO/PRJ_2002_CapteurMeteoWifi/2002_C/hard/2002_C/Project Outputs for 2002_CapteurMeteoWifi/DesignDocs/Dimensional Drawings.PDF

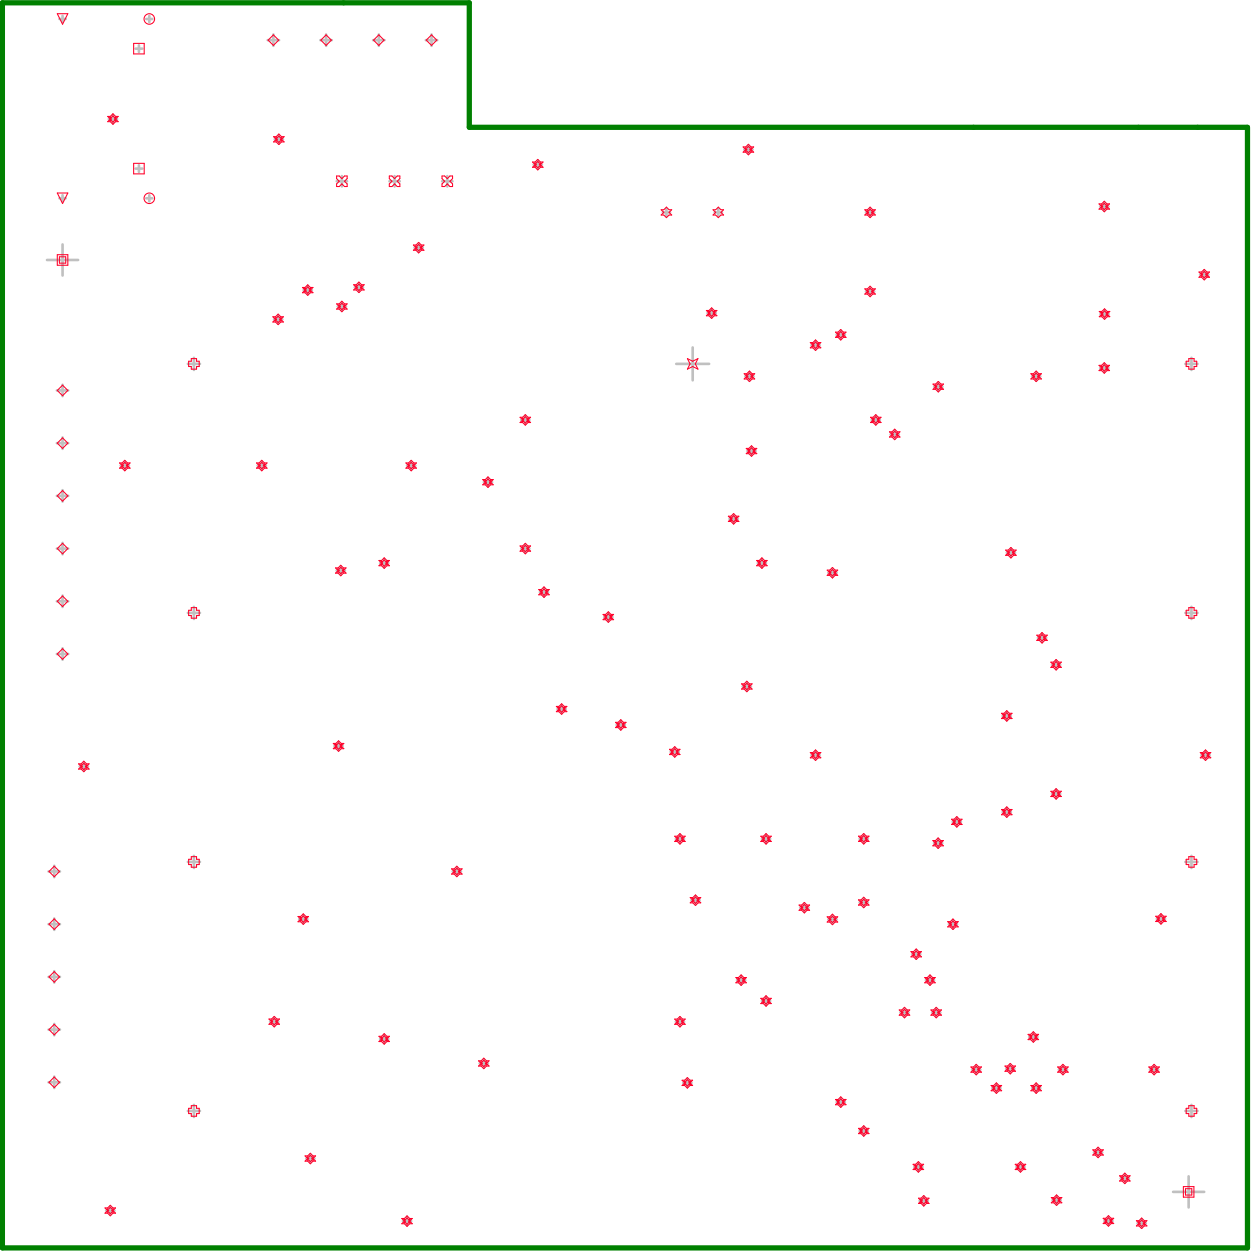
[picture p85: page 1]
