ETML-ES-SLO/PRJ_2002_CapteurMeteoWifi/2002_C/hard/2002_C/Project Outputs for 2002_CapteurMeteoWifi/DesignDocs/PCB Top-Bottom Assy Dwgs.PDF

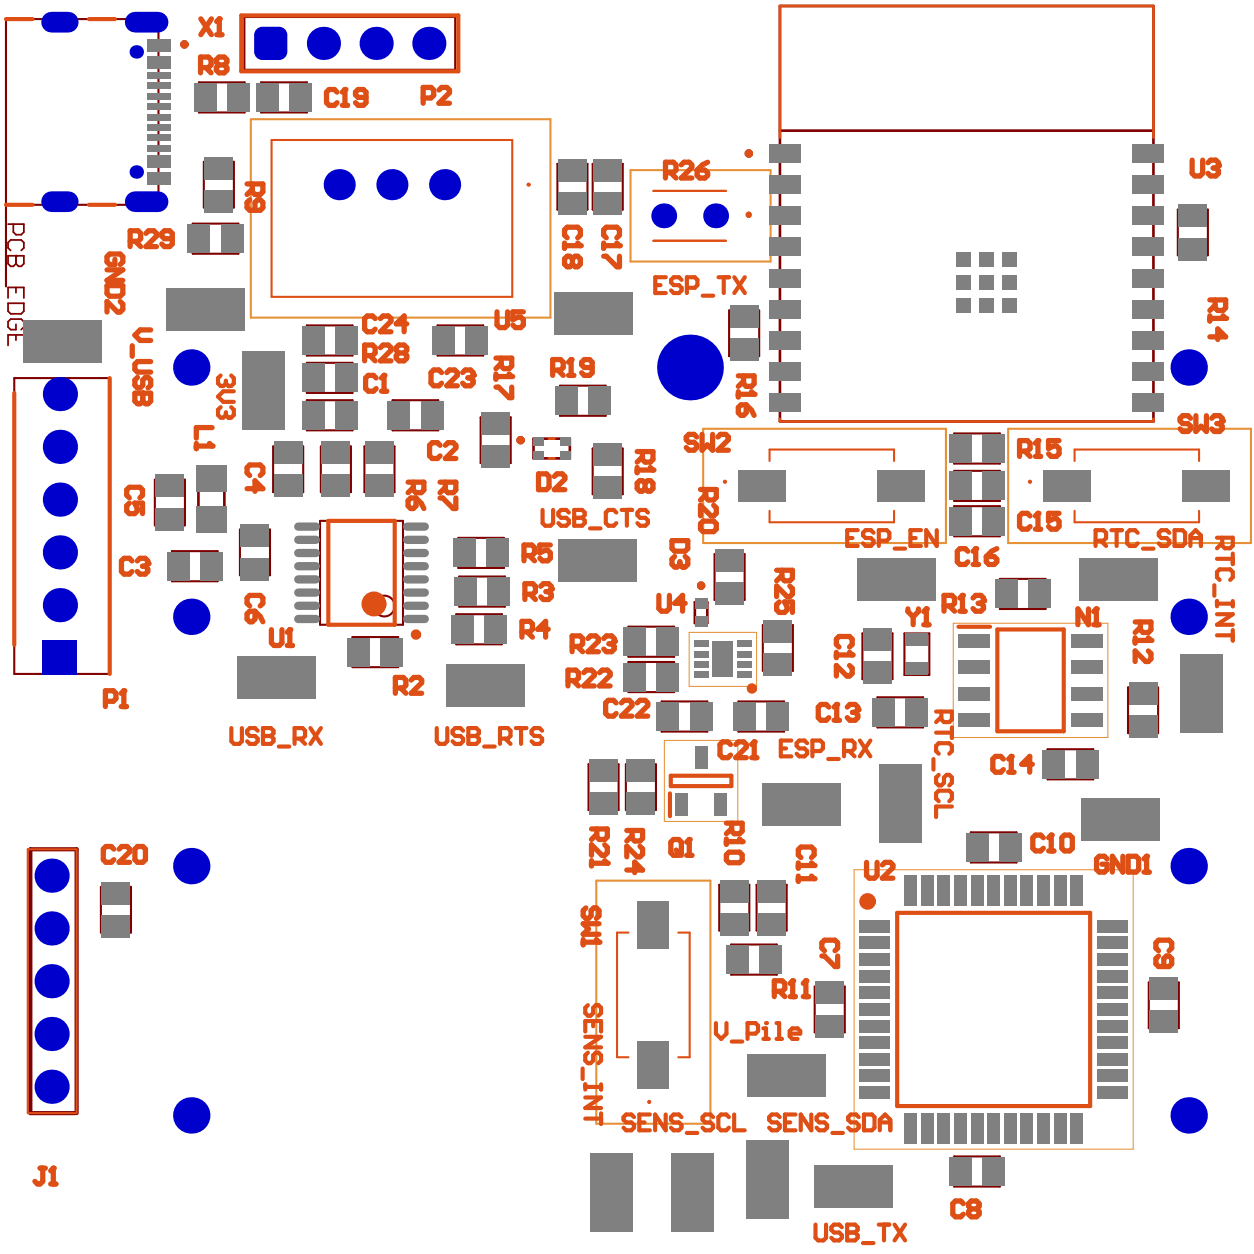
[picture p86: page 1]

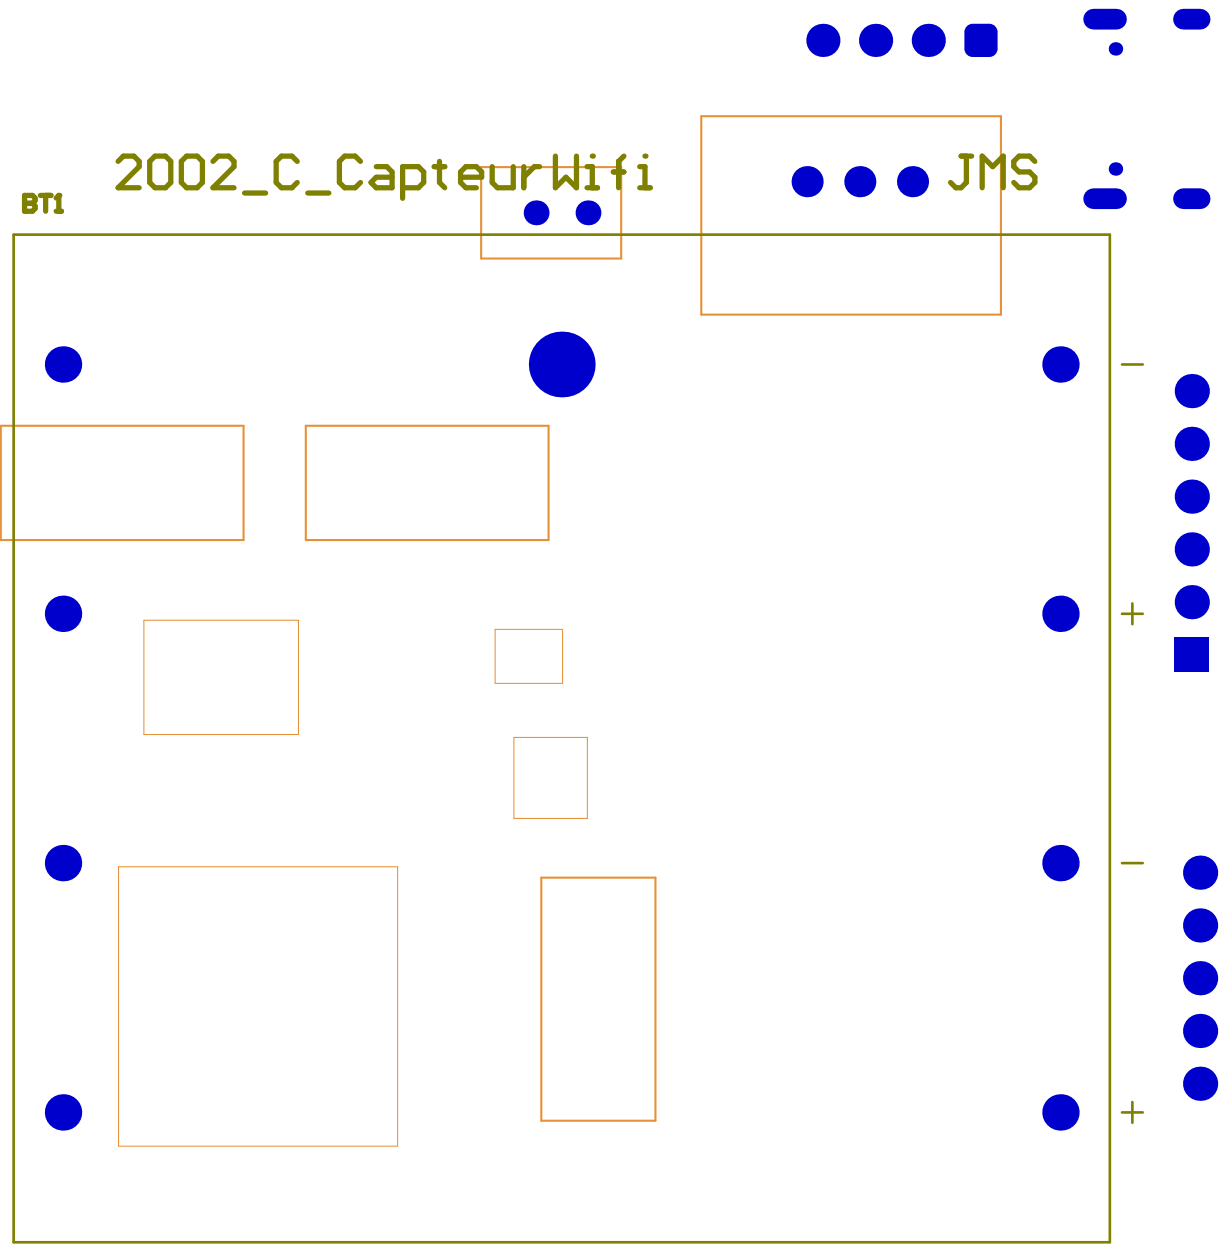
[picture p87: page 2]
