ETML-ES-SLO/PRJ_2002_CapteurMeteoWifi/(list of files, drawings)

Other design files:
2002_C/hard/2002_C/2002_CapteurMeteoWifi.PrjPcb
2002_C/hard/2002_C/2002_Pile-Accu.SchDoc
2002_C/hard/2002_C/2002_USB.SchDoc
2002_C/hard/2002_C/ES_PCB_6C_2L_2023.PcbDoc
2002_C/hard/2002_C/PCB/ES_PCB_6C_2L_2023.PcbDoc
2002_C/hard/2002_C/PcbLib1.PcbLib
2002_C/hard/2002_C/Schlib1.SchLib
2002_C/hard/2002_C/Schéma/2002_Capteur_Indication.SchDoc
2002_C/hard/2002_C/Schéma/2002_ESP32.SchDoc
2002_C/hard/2002_C/Schéma/2002_PIC32.SchDoc
2002_C/hard/2002_C/Schéma/2002_Pile-Accu.SchDoc
2002_C/hard/2002_C/Schéma/2002_RTC.SchDoc
2002_C/hard/2002_C/Schéma/2002_SchemaBloc.SchDoc
2002_C/hard/2002_C/Schéma/2002_USB.SchDoc
