ETML-ES-SLO/PRJ_2002_CapteurMeteoWifi/2002_C/soft/2002/firmware/src/RTC_I2cUtilCCS.c

/*--------------------------------------------------------*/
//      RTC_I2cUtilCCS.c
/*--------------------------------------------------------*/
//	Description :	utilitaire I2C compatible syntaxe CCS
//                      Obtenu par modification de l'exemple harmony
//
//	Auteur 		: 	C. HUBER
//
//	Version		:	V1.2
//	Compilateur	:	XC32 V1.40 & Harmony V1.06
// Modifications :
//      CHR 19.03.2015  Migration sur plib_i2c de Harmony 1.00   CHR
//      CHR 12.04.2016  adaptaion détails pour plib_i2c de Harmony 1.06   CHR
//		SCA 04.04.2017  Compléments commentaires i2c_init HighFrequencyEnable/Disable
//
/*--------------------------------------------------------*/

#include "app.h"
#include "RTC_I2cUtilCCS.h"
#include "peripheral\i2c\plib_i2c.h"
#include "peripheral\osc\plib_osc.h"



// KIT 32MX795F512L Constants
#define KIT_I2C_BUS   I2C_ID_1
#define I2C_CLOCK_FAST 400000
#define I2C_CLOCK_SLOW 100000

//------------------------------------------------------------------------------
// i2c_init
//
// Initialisationde l'I2c
//      si bool Fast = false  LOW speed   100 KHz
//      si bool Fast = true   HIGH speed  400 KHz
//------------------------------------------------------------------------------
// Adaptation plib_i2c  : 19.03.2015 CHR
// CHR 12.04.2016 reprise principe init du driver I2C de Harmony 1.06
// = pas OK reprise ancien principe            

uint32_t I2cConReg, I2cBrg;     // pour controle de la configuration

void RTC_i2c_init( bool Fast )
{
    PLIB_I2C_Disable(KIT_I2C_BUS);      // Ajout CHR
    
	// LOW frequency is enabled (**NOTE** PLIB function logic reverted)
	// A 100k et 400kHz, on devrait activer le "slope control" 
	// (cf. § I2C datasheet PIC32). Toutefois, le LM92 a des problèmes 
	// d'incompatibilité avec les flancs trop lents => désactivé
	// Voir application note 
	// "AN-2113 Applying I2C Compatible Temperature Sensors in Systems with Slow Clock Edges"
    PLIB_I2C_HighFrequencyEnable(KIT_I2C_BUS);
    if (Fast)  {
       PLIB_I2C_BaudRateSet(KIT_I2C_BUS,
               SYS_CLK_PeripheralFrequencyGet(CLK_BUS_PERIPHERAL_1), I2C_CLOCK_FAST);
    } else {
        PLIB_I2C_BaudRateSet(KIT_I2C_BUS,
               SYS_CLK_PeripheralFrequencyGet(CLK_BUS_PERIPHERAL_1), I2C_CLOCK_SLOW);
    }
	
	// selon driver. Voir commentaire PLIB_I2C_HighFrequencyEnable ci-dessus
    // PLIB_I2C_HighFrequencyDisable(KIT_I2C_BUS);   
    
    PLIB_I2C_SlaveClockStretchingEnable(KIT_I2C_BUS);  // ajout CHR
    
    PLIB_I2C_Enable(KIT_I2C_BUS);

    I2cConReg = I2C2CON;
    I2cBrg = I2C2BRG;
}


//------------------------------------------------------------------------------
// i2c_start()
//
// Début la transaction I2C master
//
// Adaptation plib_i2c  : 19.03.2015 CHR

void RTC_i2c_start(void)
{
    // int DebugCode = 0;

    // Wait for the bus to be idle, then start the transfer
    while(PLIB_I2C_BusIsIdle(KIT_I2C_BUS) == false);

     /* Check for recieve overflow */
    if ( PLIB_I2C_ReceiverOverflowHasOccurred(KIT_I2C_BUS))
    {
        PLIB_I2C_ReceiverOverflowClear(KIT_I2C_BUS);
    }

    /* Check for transmit overflow */
    if (PLIB_I2C_TransmitterOverflowHasOccurred(KIT_I2C_BUS))
    {
        PLIB_I2C_TransmitterOverflowClear(KIT_I2C_BUS);
    }

    PLIB_I2C_MasterStart(KIT_I2C_BUS);

    if (PLIB_I2C_ArbitrationLossHasOccurred(KIT_I2C_BUS));
    {
        // DBPRINTF("Error: Bus collision during transfer Start\n");
        // DebugCode = 1;
        // Handel bus collision
        PLIB_I2C_ArbitrationLossClear(KIT_I2C_BUS);
    }
   
    // Wait for the signal to complete
    while (PLIB_I2C_StartWasDetected(KIT_I2C_BUS) == false);
   
 } // end i2c_start

void RTC_i2c_reStart(void)
{
   // int DebugCode = 0;
  
   // Pas d'attente bus en Idle

   /* Check for recieve overflow */
   if ( PLIB_I2C_ReceiverOverflowHasOccurred(KIT_I2C_BUS))
   {
       PLIB_I2C_ReceiverOverflowClear(KIT_I2C_BUS);
   }

   /* Check for transmit overflow */
   if (PLIB_I2C_TransmitterOverflowHasOccurred(KIT_I2C_BUS))
   {
        PLIB_I2C_TransmitterOverflowClear(KIT_I2C_BUS);
   }

   // PLIB_I2C_StartClear(KIT_I2C_BUS);
   PLIB_I2C_MasterStartRepeat(KIT_I2C_BUS);
   
   if (PLIB_I2C_ArbitrationLossHasOccurred(KIT_I2C_BUS));
    {
        // DBPRINTF("Error: Bus collision during transfer Start\n");
        // DebugCode = 1;
        // Handel bus collision
        PLIB_I2C_ArbitrationLossClear(KIT_I2C_BUS);
    }
    
   // Wait for the signal to complete
   while (PLIB_I2C_StartWasDetected(KIT_I2C_BUS) == false);
  
} // end i2c_reStart


//------------------------------------------------------------------------------
// i2c_write()
//
// Syntaxe : 	i2c_write (data);
// Le paramètre data est la valeur 8 bits à transmettre.
// En mode maître, la fonction génère le signal d'horloge, en mode esclave elle attend le signal d'horloge du maître.
// En outre cette fonction retourne le bit ACK, 0 = ACK, 1 = NO_ACK.
//
//------------------------------------------------------------------------------
//
// Modification de  BOOL TransmitOneByte( UINT8 data )
// - Ajout retour du bit Ack
// Adaptation plib_i2c  : 19.03.2015 CHR

bool RTC_i2c_write( uint8_t data )
{
    bool  AckBit;
  
    // Wait for the bus to be idle (nécessaire aprés un reStart)
    while(PLIB_I2C_BusIsIdle(KIT_I2C_BUS) == false);

    // Wait for the transmitter to be ready
    while( PLIB_I2C_TransmitterIsReady(KIT_I2C_BUS) == false);

    
    // Transmit the byte
    PLIB_I2C_TransmitterByteSend(KIT_I2C_BUS, data);
    
    while(PLIB_I2C_TransmitterIsBusy(KIT_I2C_BUS));              //Wait as long as TBF = 1
    while(!PLIB_I2C_TransmitterByteHasCompleted(KIT_I2C_BUS));   //Wait as long as TRSTAT == 1
  
    AckBit = PLIB_I2C_TransmitterByteWasAcknowledged(KIT_I2C_BUS);
   
    return AckBit;
} // end i2c_write



//------------------------------------------------------------------------------
// i2c_stop()
//
// termine la transaction I2C master
//
//------------------------------------------------------------------------------
//
// Modification de  void StopTransfer( void )
// - pas de modif sauf le nom de la fonction
// Adaptation plib_i2c  : 19.03.2015 CHR


void RTC_i2c_stop( void )
{
    // Attente bus au repos
    while(PLIB_I2C_BusIsIdle(KIT_I2C_BUS) == false);

    PLIB_I2C_MasterStop(KIT_I2C_BUS);

    // Wait for the signal to complete
    while (PLIB_I2C_StopWasDetected(KIT_I2C_BUS) == false);
   
} // end i2c_stop

//------------------------------------------------------------------------------
// i2c_read()
//
// Syntaxe : 	data = i2c_read (ack);
// La fonction retourne l'octet lu.
// Le paramètre ack :
// 1 (true)  signifie qu'il faut effectuer l'acquittement.
// 0 (false) signifie qu'il ne faut pas effectuer l'acquittement.
//
// Adaptation plib_i2c  : 19.03.2015 CHR

uint8_t RTC_i2c_read(bool ackTodo)
{
    uint8_t i2cByte;

    // BSP_LEDOn(BSP_LED_5);  // provisoire : pour observation
   
    // ajout idem driver statique I2C de Harmony 1_03
    if ( PLIB_I2C_ReceiverOverflowHasOccurred(KIT_I2C_BUS))
    {
        i2cByte = PLIB_I2C_ReceivedByteGet(KIT_I2C_BUS);
        PLIB_I2C_ReceiverOverflowClear(KIT_I2C_BUS);
    }
    
    // en relation avec stetching
    PLIB_I2C_SlaveClockRelease(KIT_I2C_BUS);

    // Set Rx enable in MSTR which causes SLAVE to send data
    PLIB_I2C_MasterReceiverClock1Byte(KIT_I2C_BUS);

    // Wait till RBF = 1; Which means data is available in I2C2RCV reg
    while(!PLIB_I2C_ReceivedByteIsAvailable(KIT_I2C_BUS));
    
    i2cByte = PLIB_I2C_ReceivedByteGet(KIT_I2C_BUS); //Read from I2CxRCV

    while ( PLIB_I2C_MasterReceiverReadyToAcknowledge ( KIT_I2C_BUS ) == false );

     if (ackTodo) {
          PLIB_I2C_ReceivedByteAcknowledge ( KIT_I2C_BUS, true );
     } else {
          PLIB_I2C_ReceivedByteAcknowledge ( KIT_I2C_BUS, false );
     }

    // wait till ACK/NACK sequence is complete i.e ACKEN = 0
    while( PLIB_I2C_MasterReceiverReadyToAcknowledge (KIT_I2C_BUS) == false);
   
    // BSP_LEDOff(BSP_LED_5); // provisoire : pour observation

    return i2cByte;
} // end i2c_read
