ETML-ES-SLO/PRJ_2002_CapteurMeteoWifi/(commit log)

2024-09-04 Projet diplome version C - JMS
    [NoProjet_NomProjet-BOM-v1.XLS, Planning_2002_JMS.xlsx]
2024-09-09 Version finale TD - JMS
    [2002_CapteurMeteoWifi-JOURNAL.xlsx, 2002_CapteurMeteoWifi-PLANNING.xlsx, 2002_CapteurMeteoWifi.PrjPcb, 2002_Capteur_Indication.SchDoc, 2002_ESP32.SchDoc, 2002_PIC32.SchDoc, 2002_Pile-Accu.SchDoc, 2002_RTC.SchDoc]
